Tamim101/Sky_Watch/docs/img/100n03a.jpg

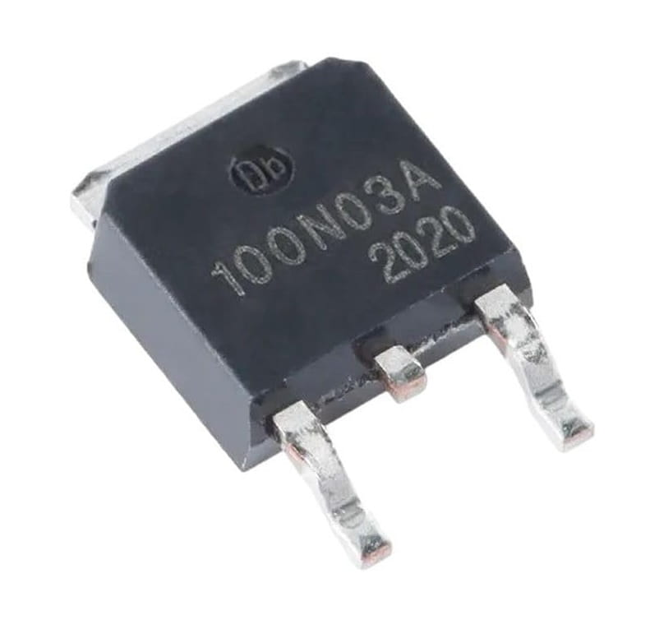
docs/img/100n03a.jpg
