Tamim101/Sky_Watch/docs/img/battery.jpg

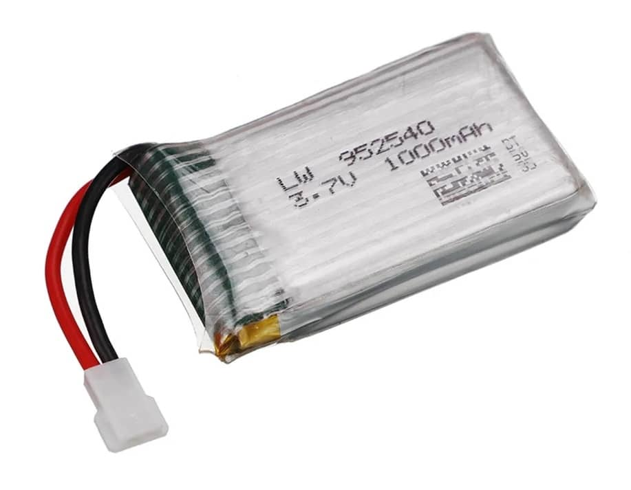
docs/img/battery.jpg
