Tamim101/Sky_Watch/docs/img/betafpv.jpg

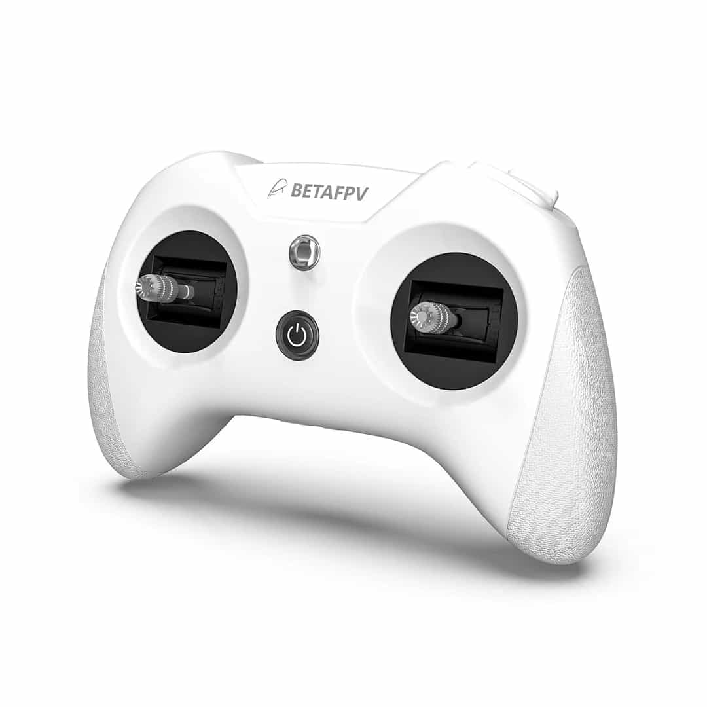
docs/img/betafpv.jpg
