Tamim101/Sky_Watch/docs/img/buck-boost.jpg

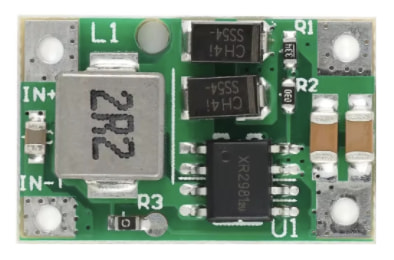
docs/img/buck-boost.jpg
