Tamim101/Sky_Watch/docs/img/charger.jpg

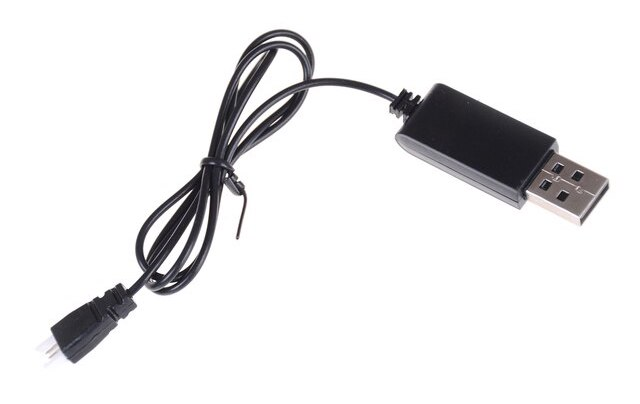
docs/img/charger.jpg
