Tamim101/Sky_Watch/docs/img/esc.jpg

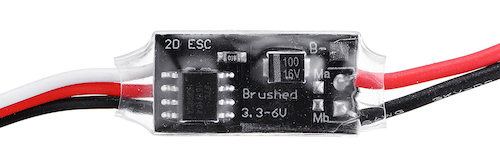
docs/img/esc.jpg
