Tamim101/Sky_Watch/docs/img/esp32-holder.jpg

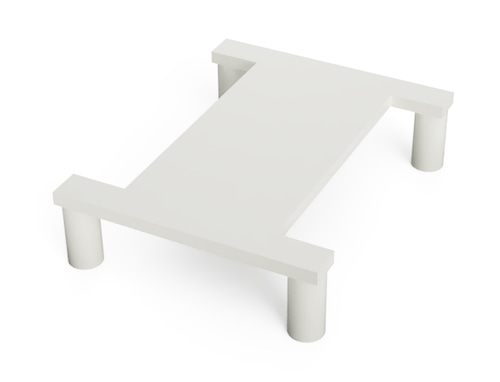
docs/img/esp32-holder.jpg
