Tamim101/Sky_Watch/docs/img/esp32.jpg

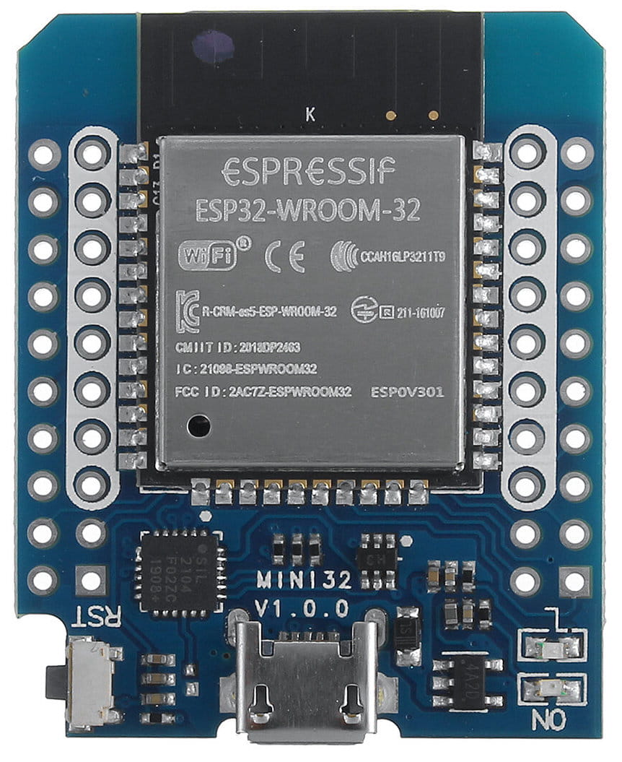
docs/img/esp32.jpg
