Tamim101/Sky_Watch/docs/img/flight-video.jpg

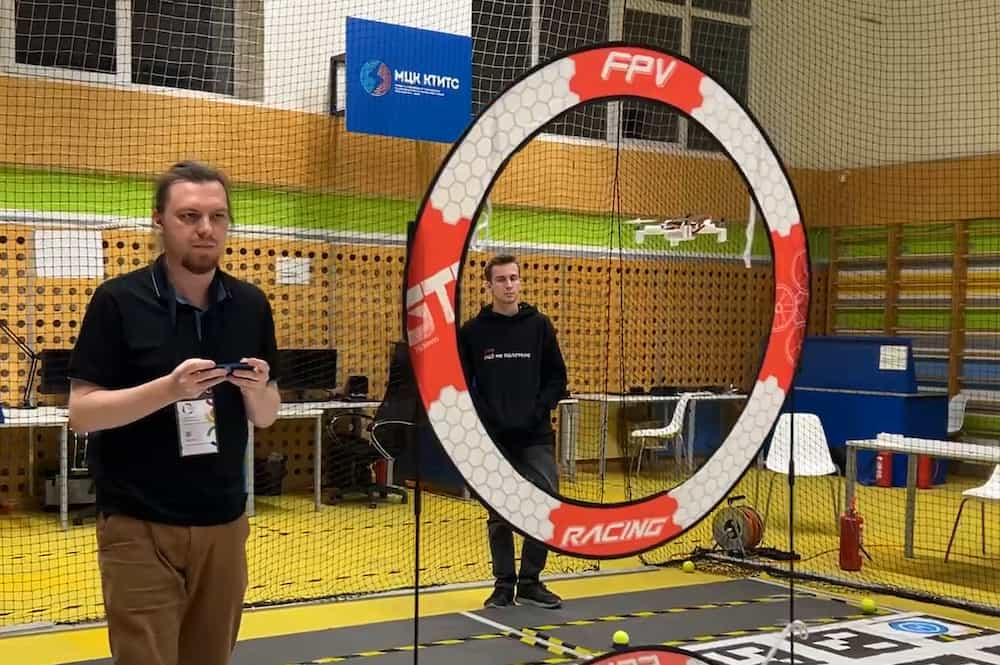
docs/img/flight-video.jpg
