Tamim101/Sky_Watch/docs/img/flightplot.png

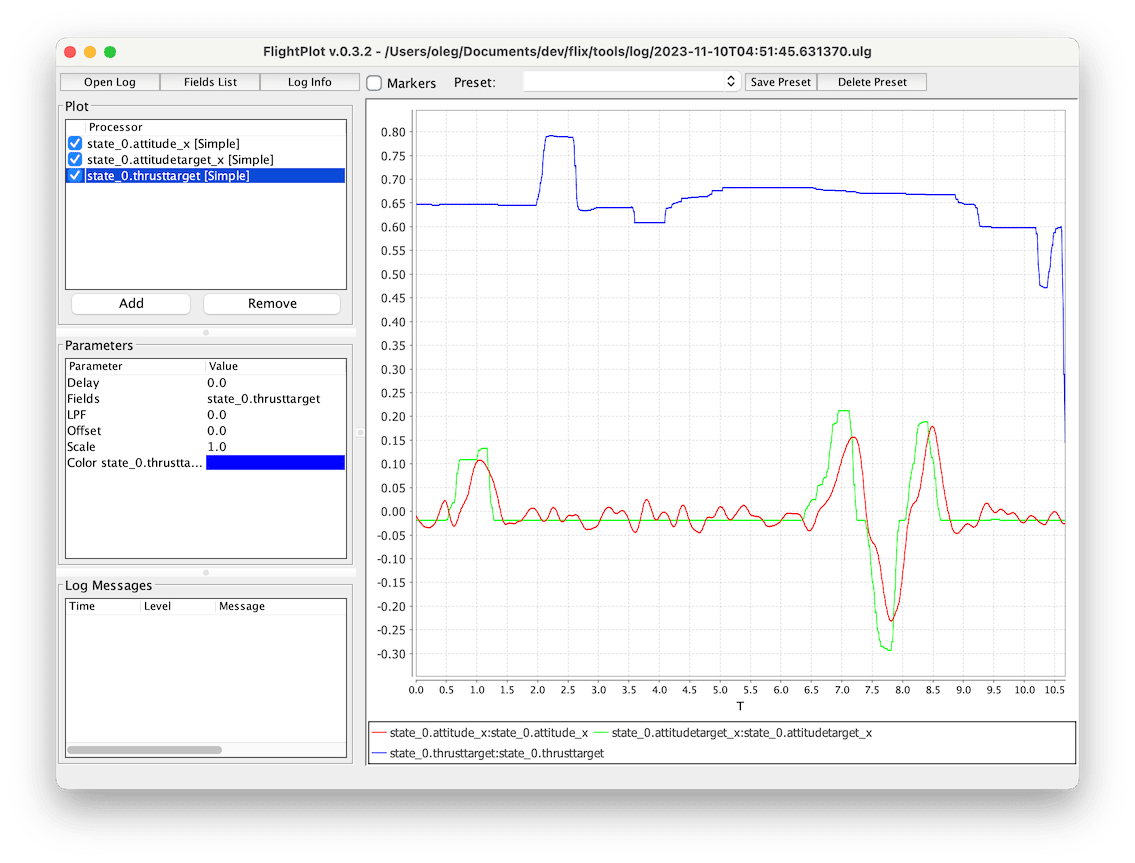
docs/img/flightplot.png
