Tamim101/Sky_Watch/docs/img/flix1.jpg

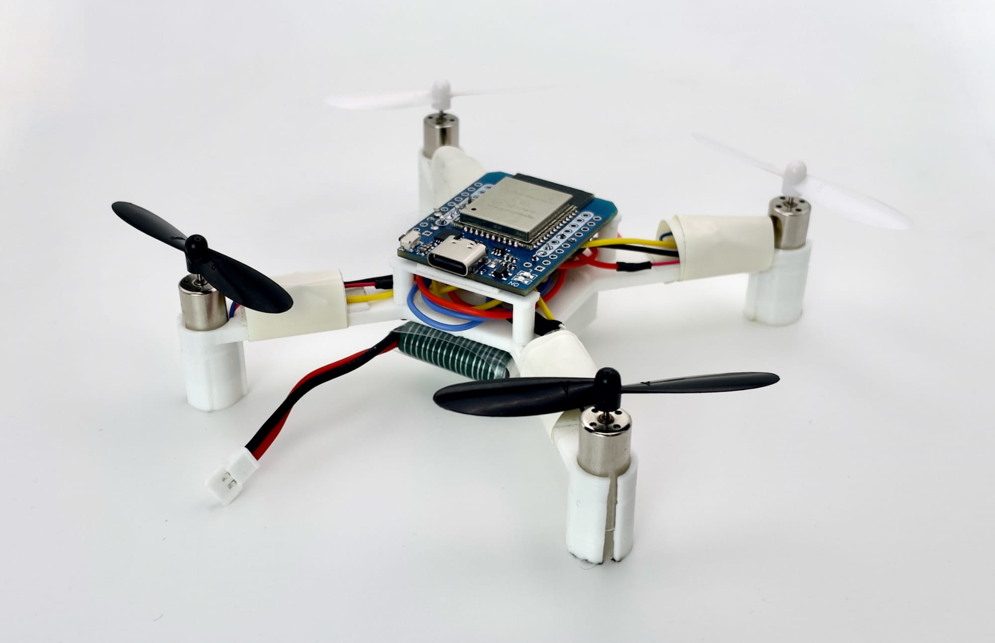
docs/img/flix1.jpg
