Tamim101/Sky_Watch/docs/img/flix.jpg

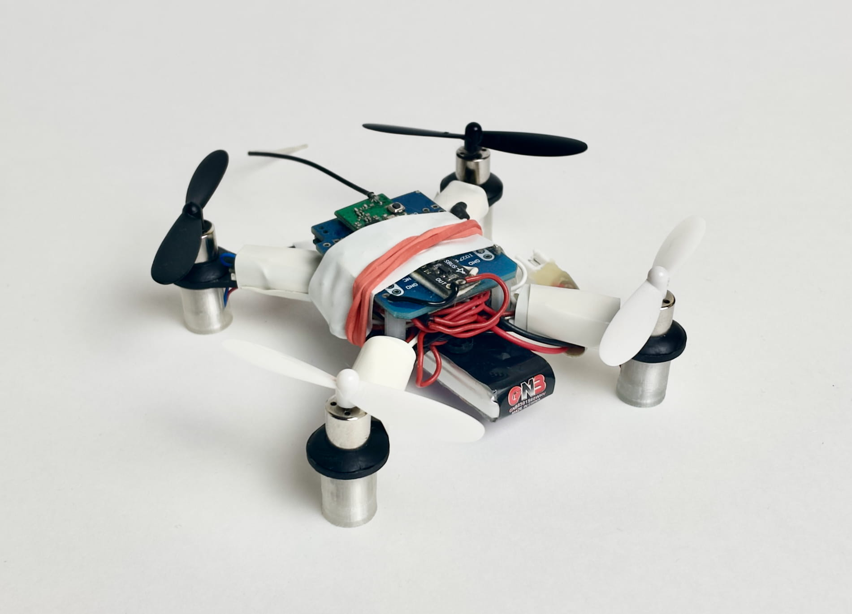
docs/img/flix.jpg
