Tamim101/Sky_Watch/docs/img/flixperiph.png

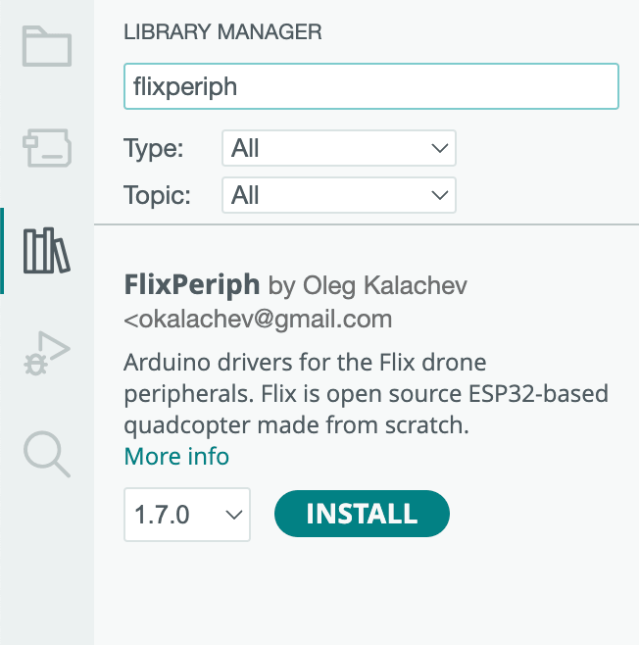
docs/img/flixperiph.png
