Tamim101/Sky_Watch/docs/img/foxglove.png

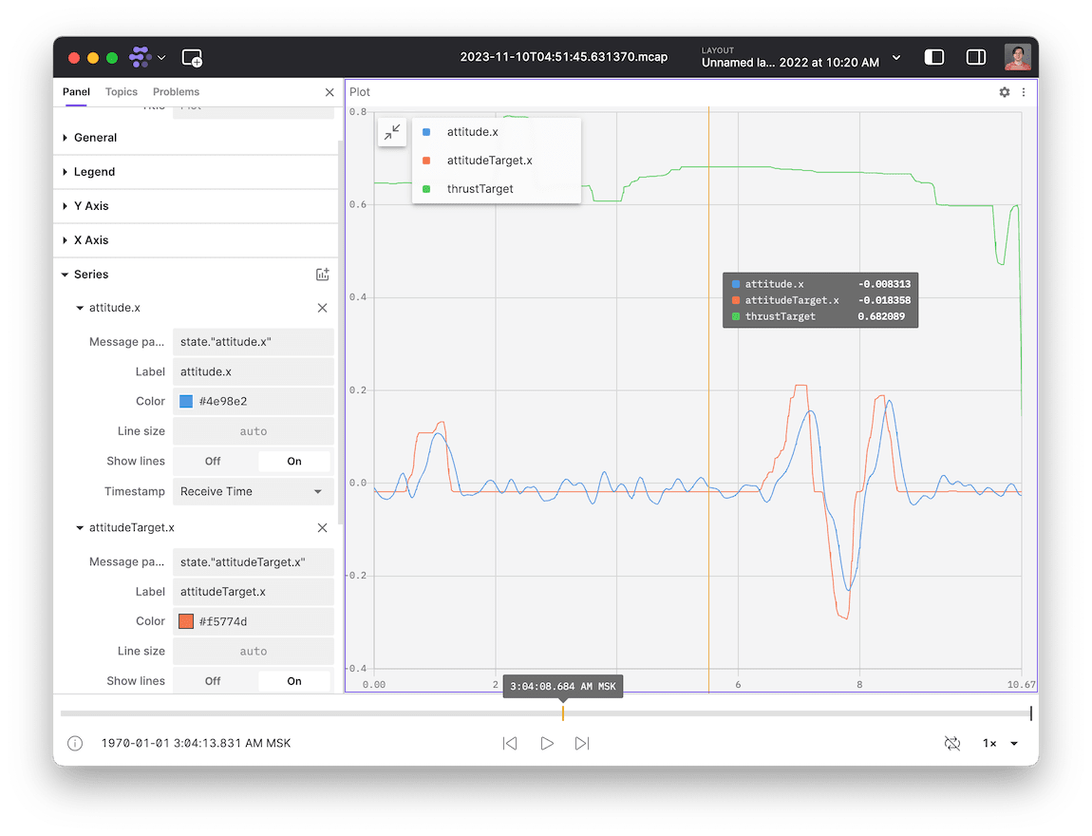
docs/img/foxglove.png
