Tamim101/Sky_Watch/docs/img/frame1.jpg

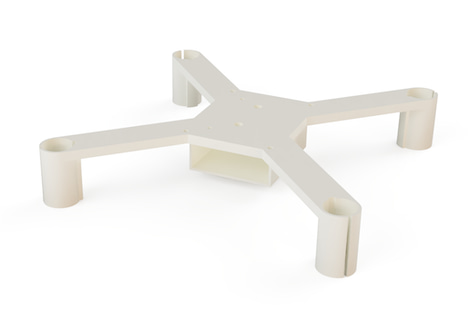
docs/img/frame1.jpg
