Tamim101/Sky_Watch/docs/img/frame.jpg

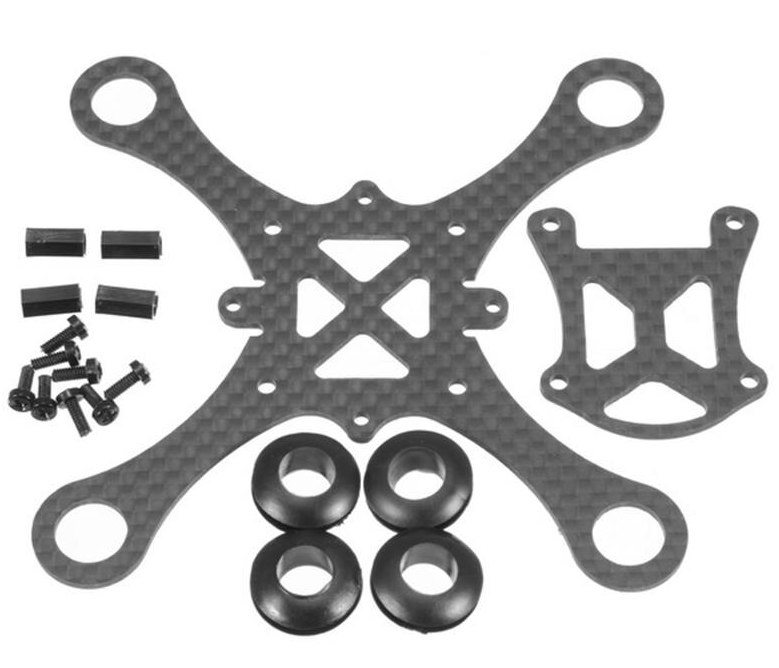
docs/img/frame.jpg
