Tamim101/Sky_Watch/docs/img/gy-91.jpg

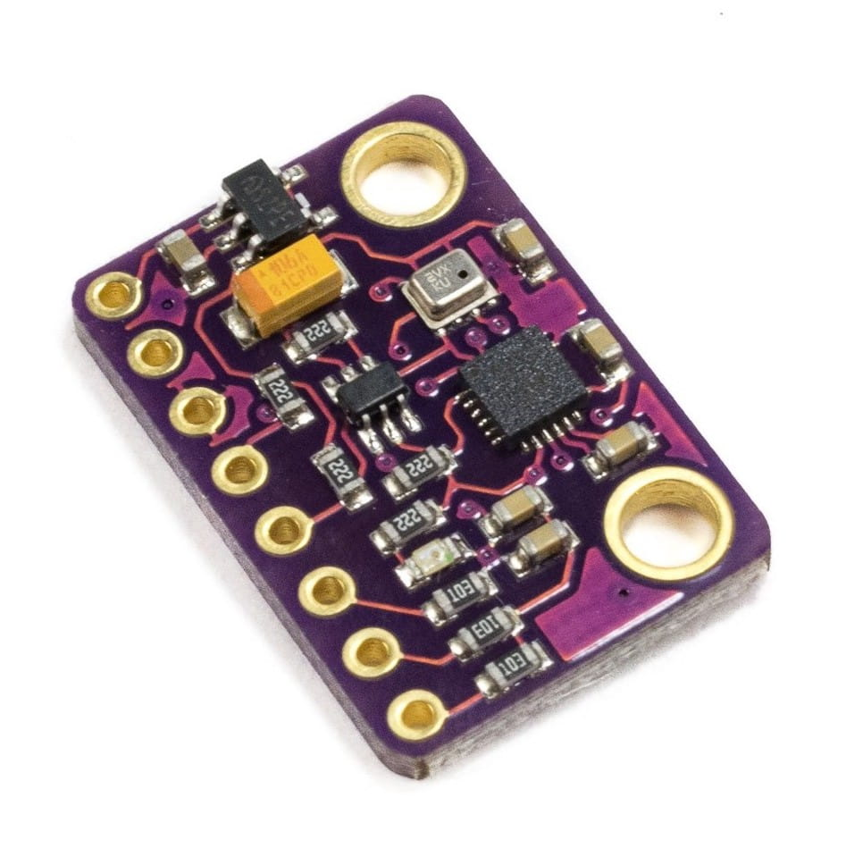
docs/img/gy-91.jpg
