Tamim101/Sky_Watch/docs/img/gy-521.jpg

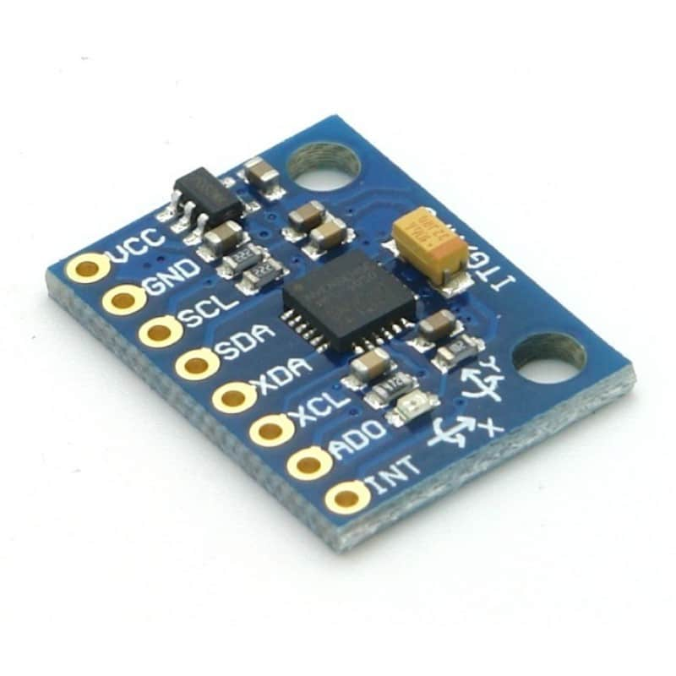
docs/img/gy-521.jpg
