Tamim101/Sky_Watch/docs/img/gyro-plotter.png

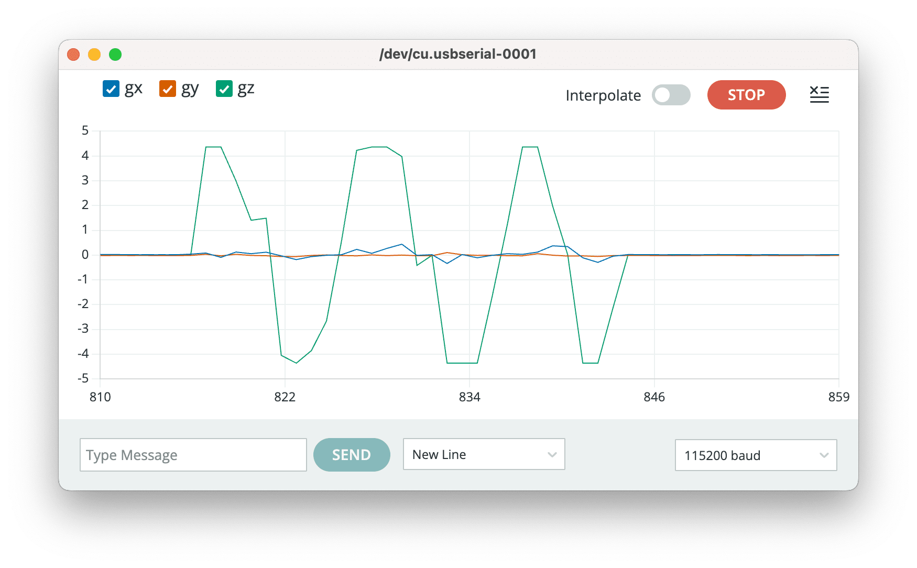
docs/img/gyro-plotter.png
