Tamim101/Sky_Watch/docs/img/gyroscope.jpg

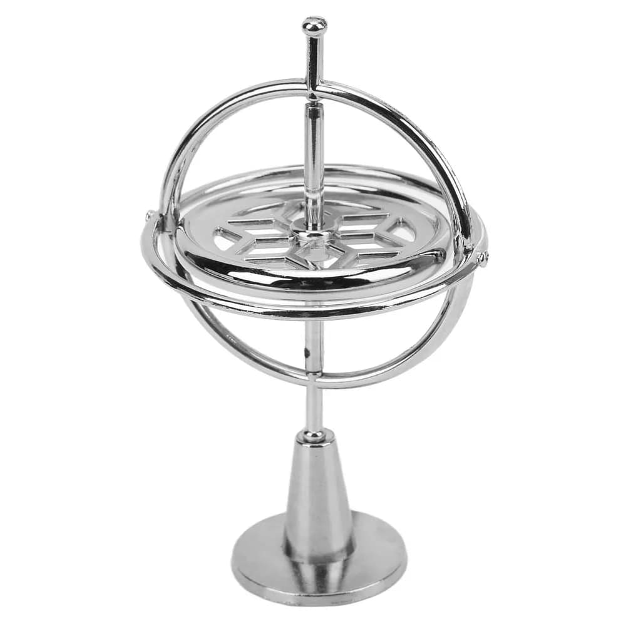
docs/img/gyroscope.jpg
