Tamim101/Sky_Watch/docs/img/icm-20948.jpg

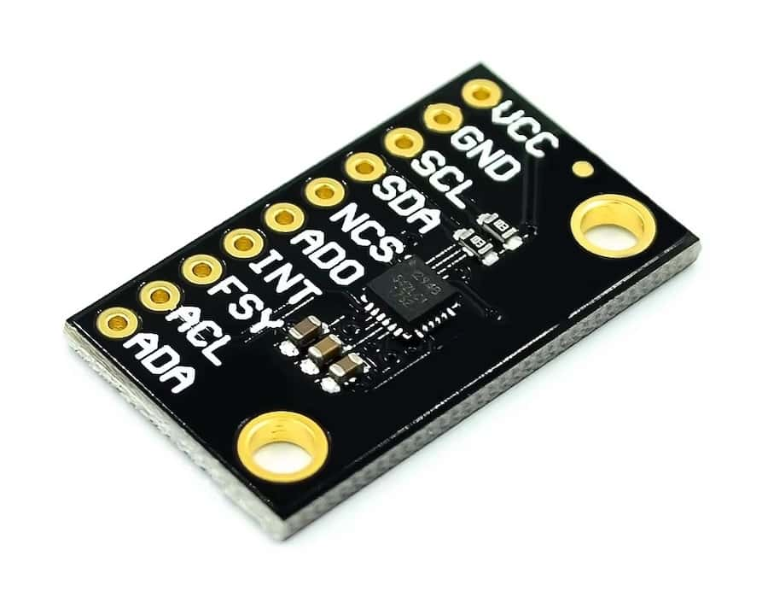
docs/img/icm-20948.jpg
