Tamim101/Sky_Watch/docs/img/inv.jpg

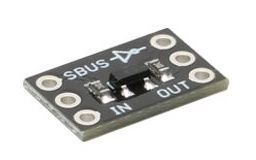
docs/img/inv.jpg
