Tamim101/Sky_Watch/docs/img/kingkong.jpg

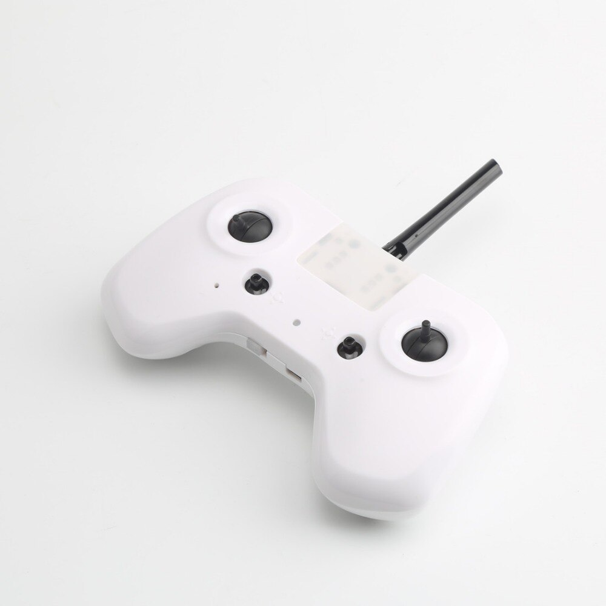
docs/img/kingkong.jpg
