Tamim101/Sky_Watch/docs/img/logitech.jpg

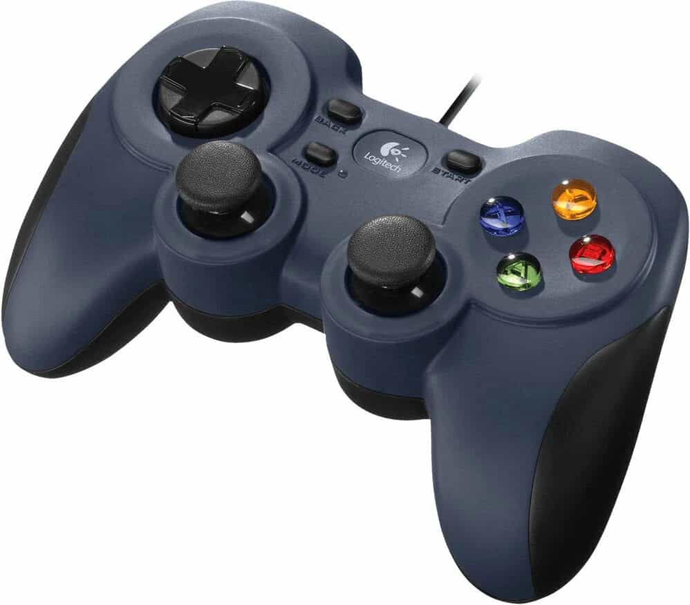
docs/img/logitech.jpg
