Tamim101/Sky_Watch/docs/img/mosfet-connection.png

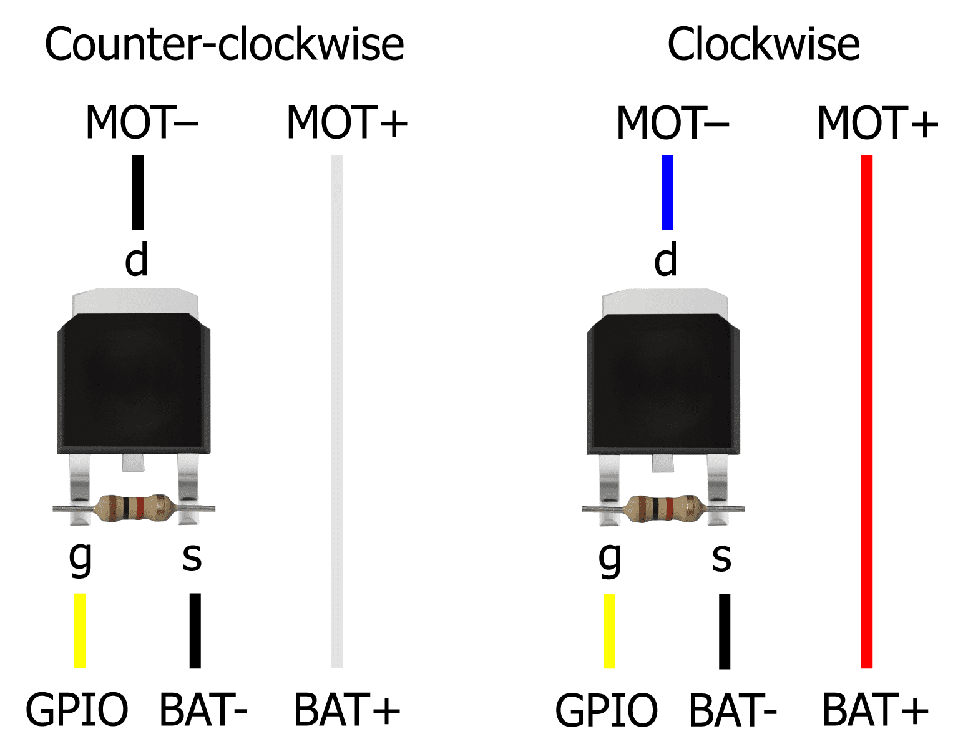
docs/img/mosfet-connection.png
