Tamim101/Sky_Watch/docs/img/motor.jpeg

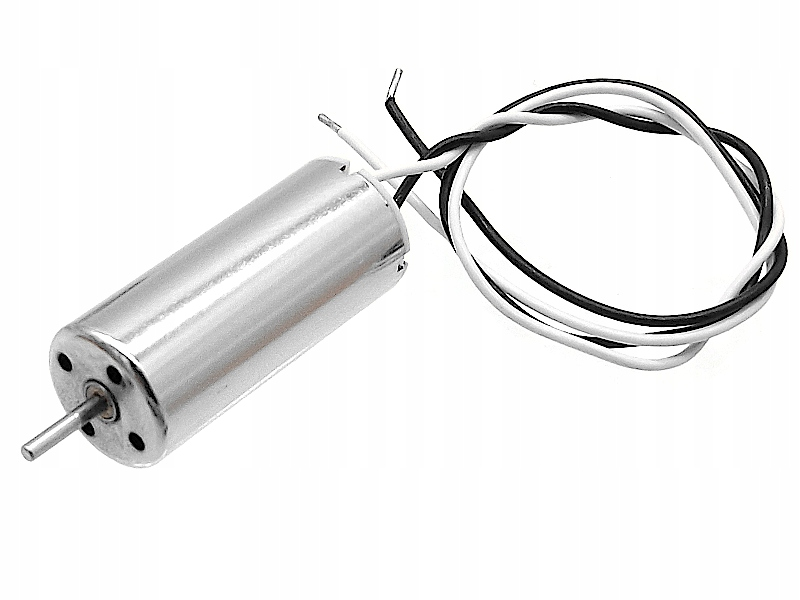
docs/img/motor.jpeg
