Tamim101/Sky_Watch/docs/img/mpu9250.jpg

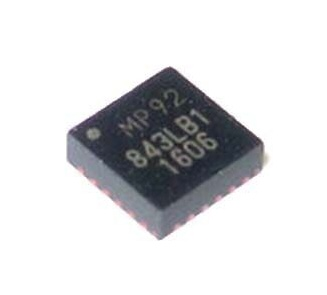
docs/img/mpu9250.jpg
