Tamim101/Sky_Watch/docs/img/mx.png

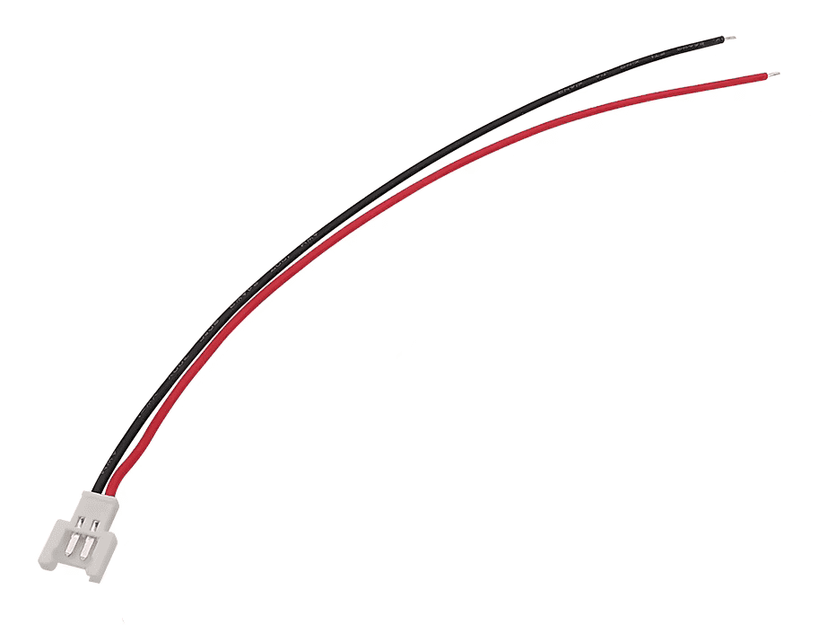
docs/img/mx.png
