Tamim101/Sky_Watch/docs/img/plotjuggler.png

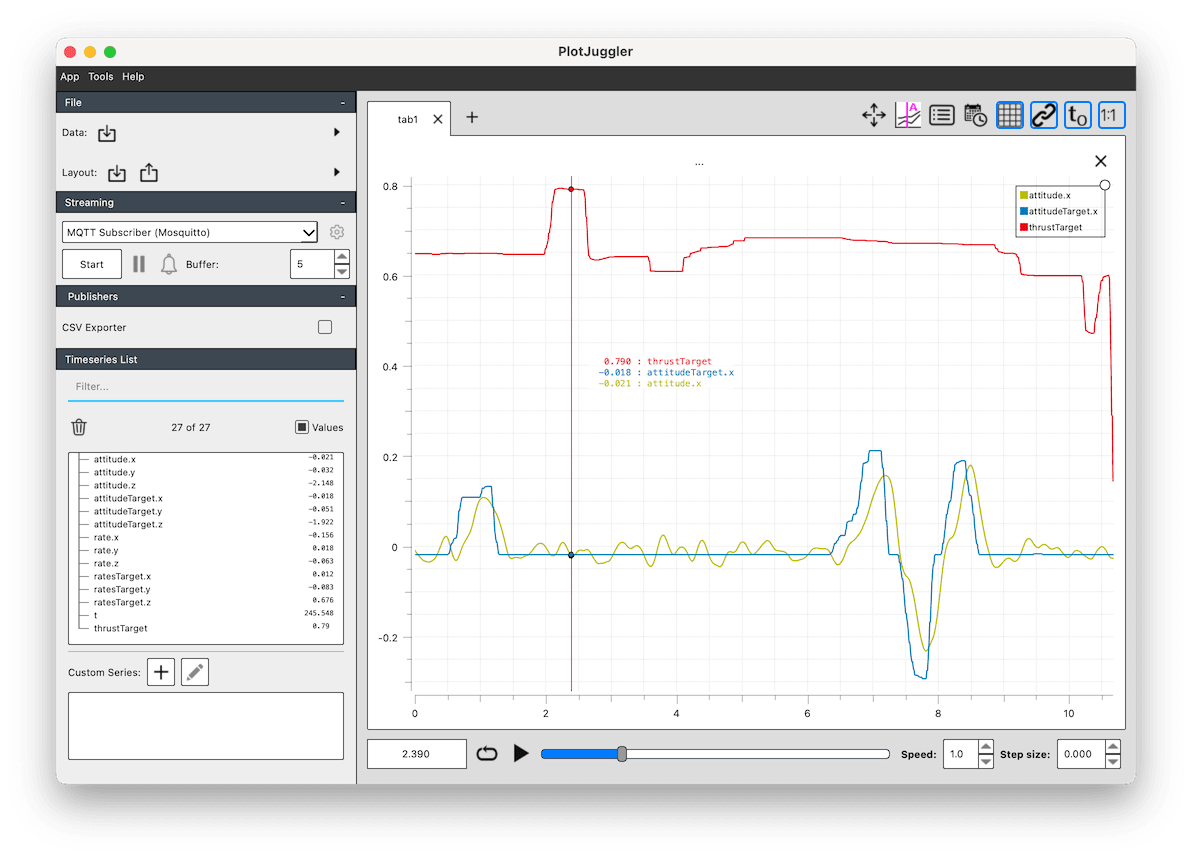
docs/img/plotjuggler.png
