Tamim101/Sky_Watch/docs/img/prop.jpg

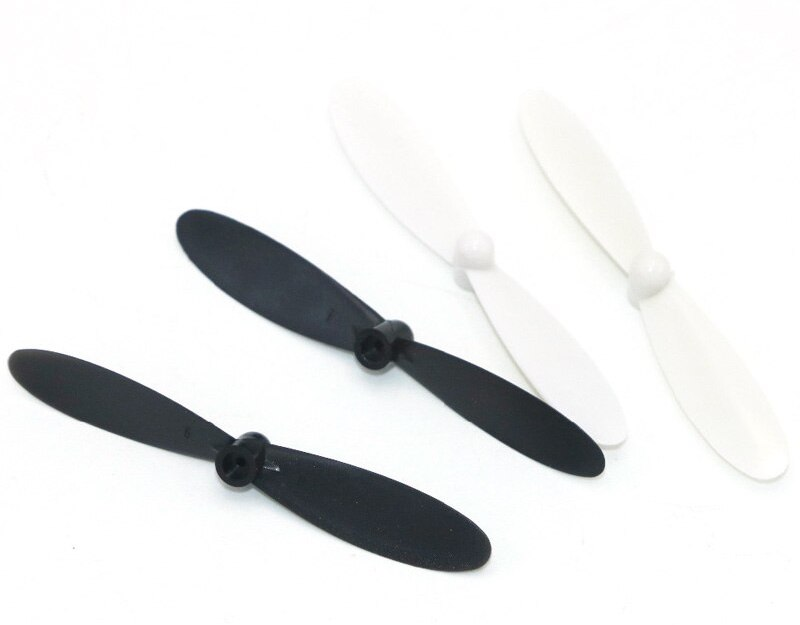
docs/img/prop.jpg
