Tamim101/Sky_Watch/docs/img/qgc-attitude.png

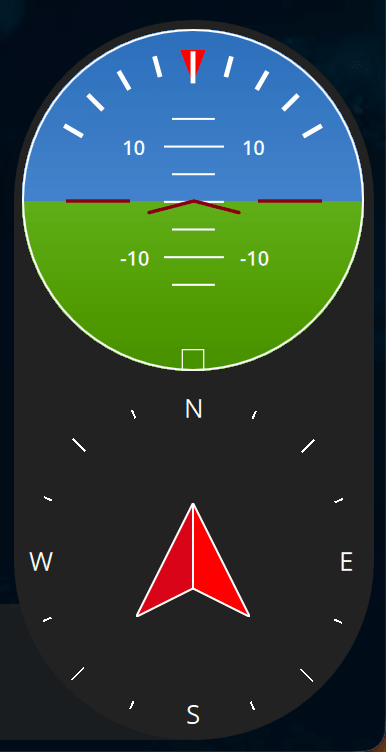
docs/img/qgc-attitude.png
