Tamim101/Sky_Watch/docs/img/qgc-proxy.png

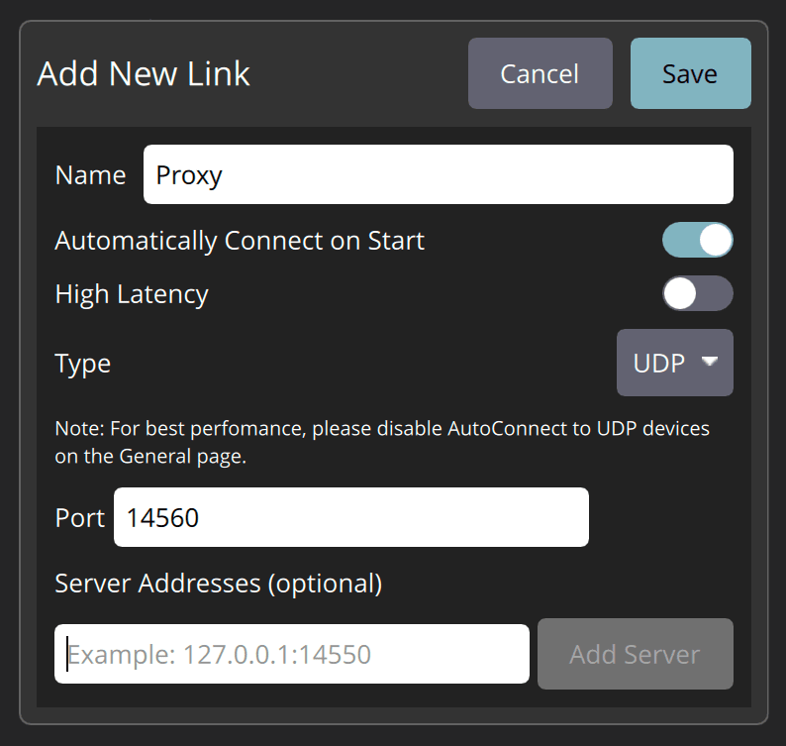
docs/img/qgc-proxy.png
