Tamim101/Sky_Watch/docs/img/resistor10k.jpg

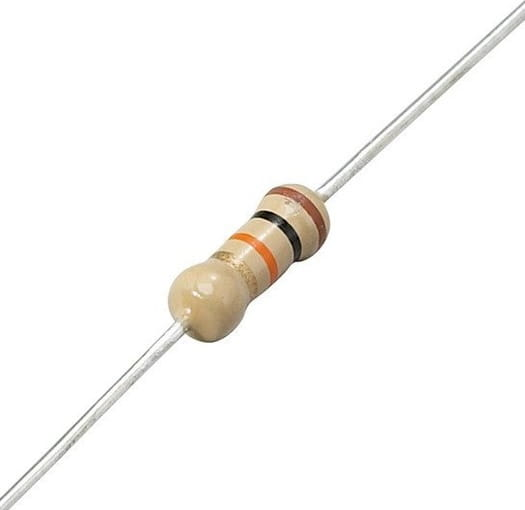
docs/img/resistor10k.jpg
