Tamim101/Sky_Watch/docs/img/rx.jpg

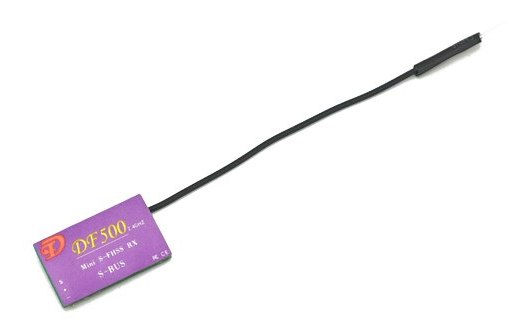
docs/img/rx.jpg
