Tamim101/Sky_Watch/docs/img/screw-m1.4.jpg

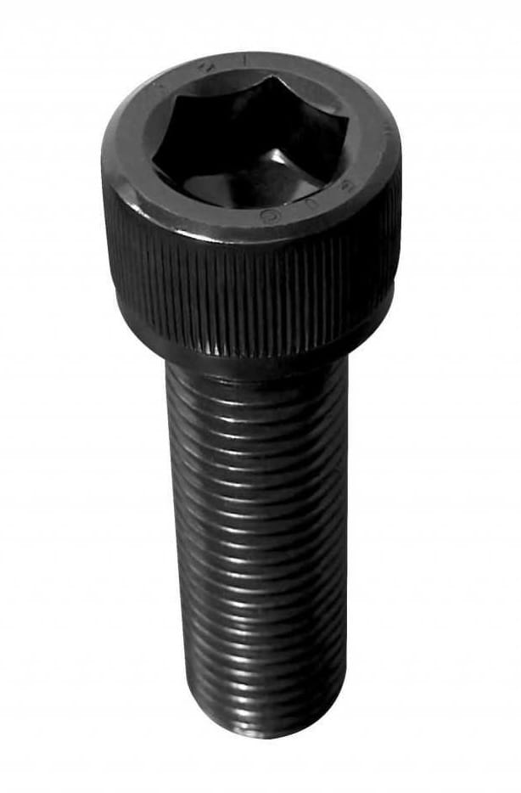
docs/img/screw-m1.4.jpg
