Tamim101/Sky_Watch/docs/img/screw-m3.jpg

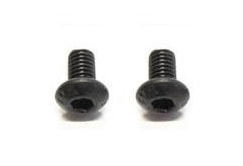
docs/img/screw-m3.jpg
