Tamim101/Sky_Watch/docs/img/simulator1.png

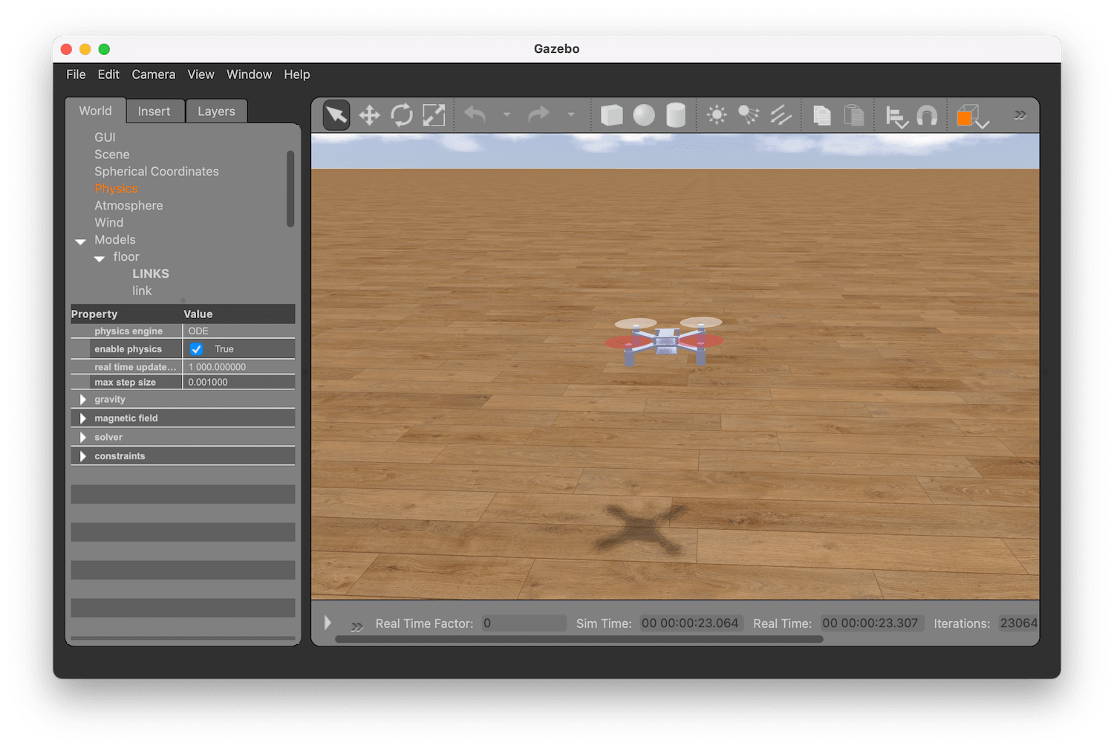
docs/img/simulator1.png
