Tamim101/Sky_Watch/docs/img/simulator.png

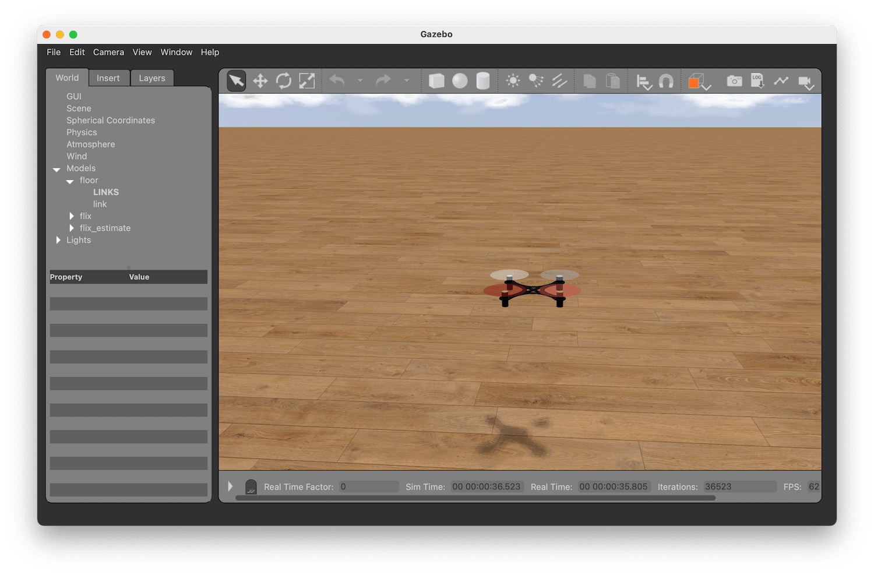
docs/img/simulator.png
