Tamim101/Sky_Watch/docs/img/user/alexey_karakash/1.jpg

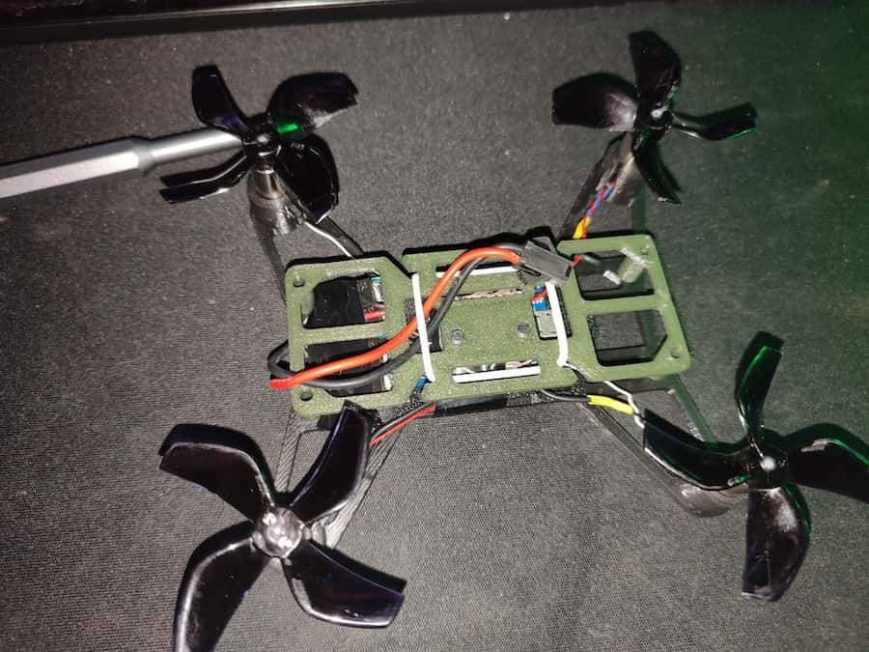
docs/img/user/alexey_karakash/1.jpg
