Tamim101/Sky_Watch/docs/img/user/alexey_karakash/2.jpg

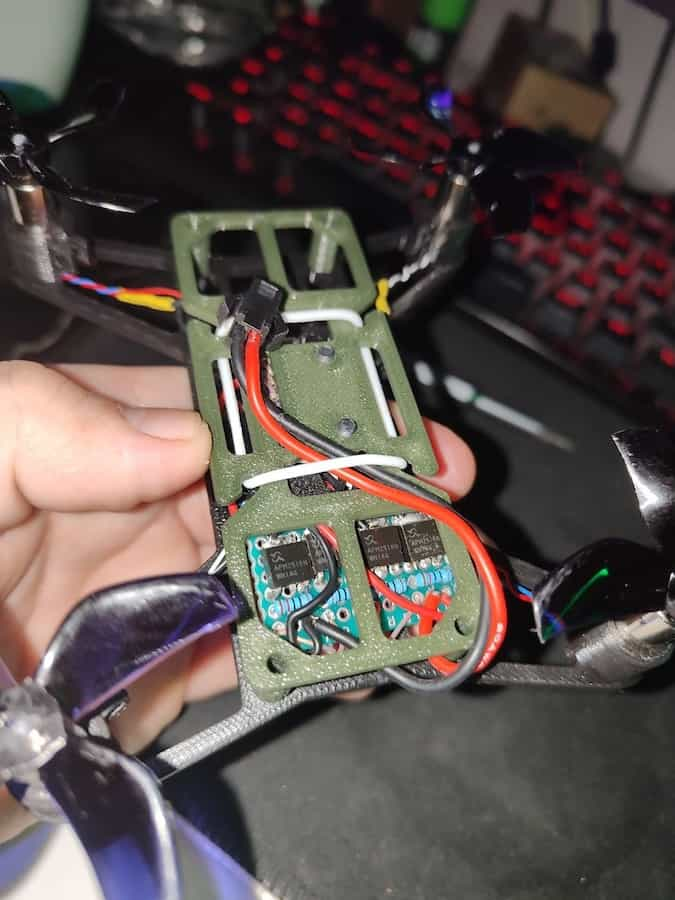
docs/img/user/alexey_karakash/2.jpg
