Tamim101/Sky_Watch/docs/img/user/alexey_karakash/3.jpg

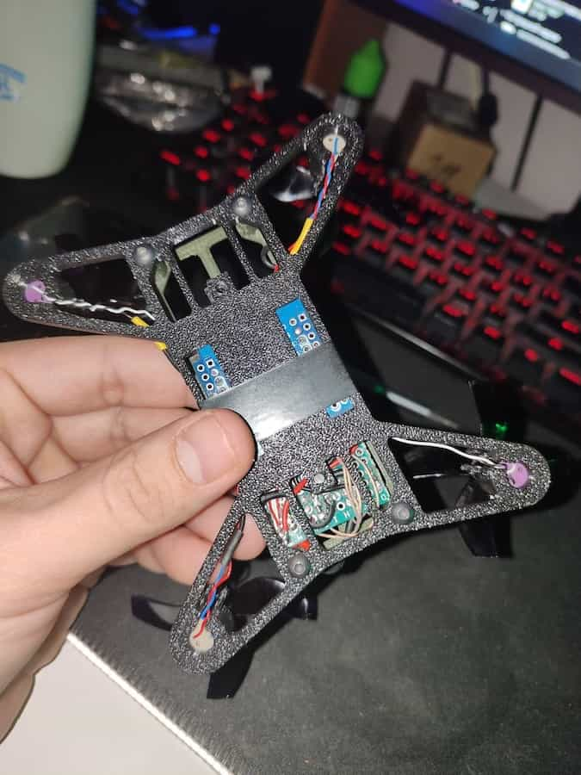
docs/img/user/alexey_karakash/3.jpg
