Tamim101/Sky_Watch/docs/img/user/alexey_karakash/4.jpg

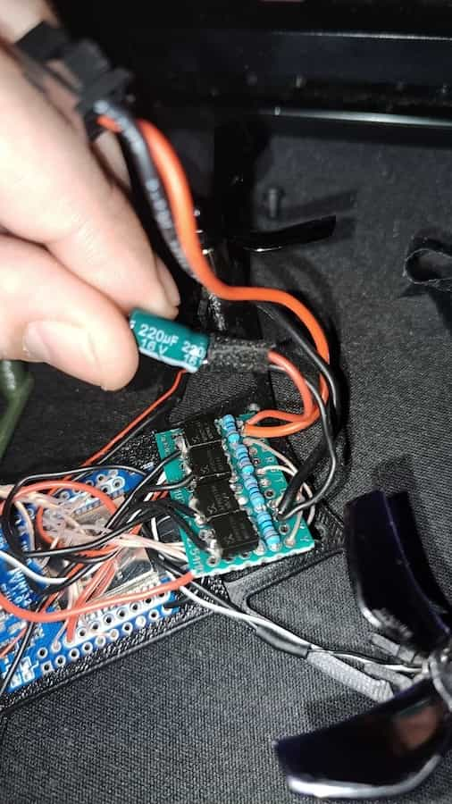
docs/img/user/alexey_karakash/4.jpg
