Tamim101/Sky_Watch/docs/img/user/alexey_karakash/video.jpg

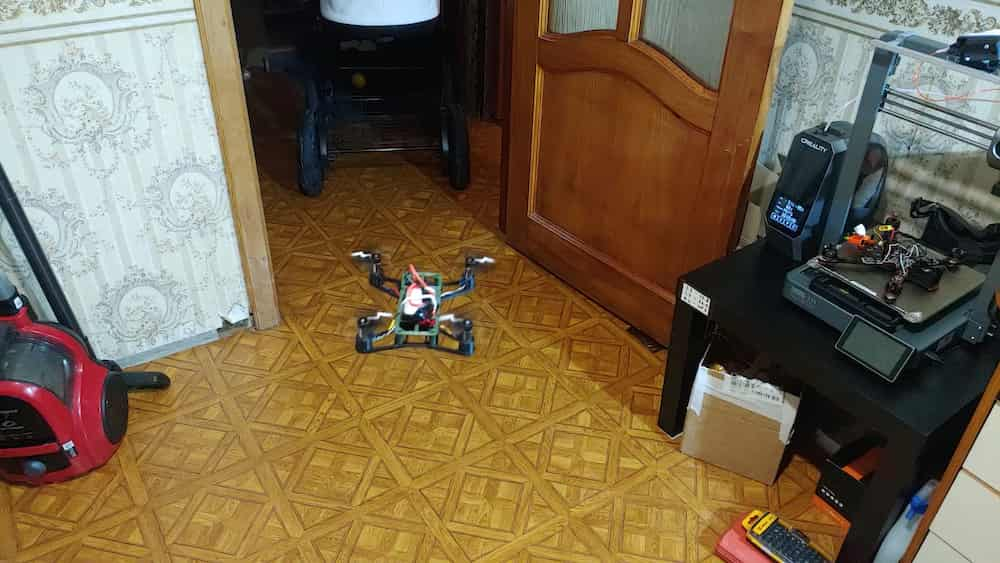
docs/img/user/alexey_karakash/video.jpg
