Tamim101/Sky_Watch/docs/img/user/chkroko-bldc/1.jpg

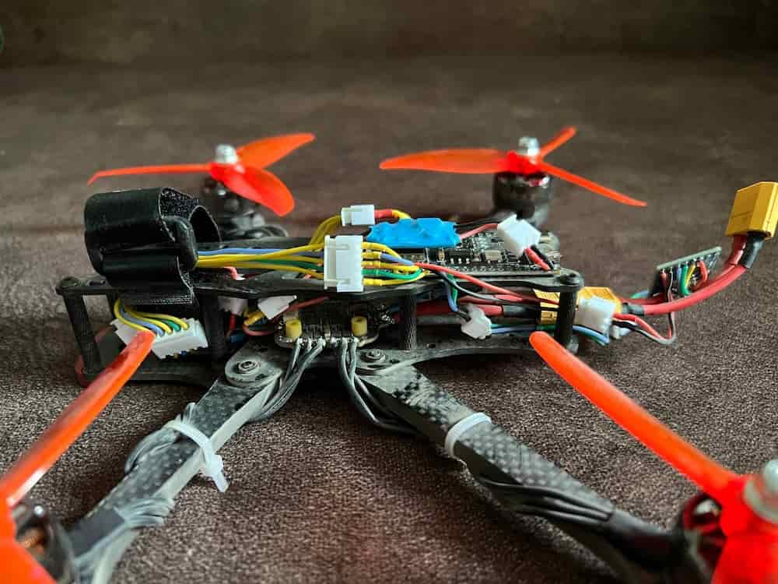
docs/img/user/chkroko-bldc/1.jpg
