Tamim101/Sky_Watch/docs/img/user/chkroko-bldc/2.jpg

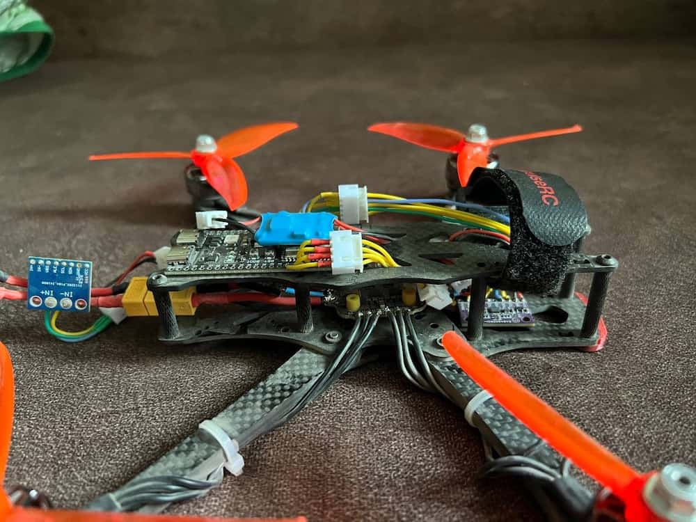
docs/img/user/chkroko-bldc/2.jpg
