Tamim101/Sky_Watch/docs/img/user/chkroko-bldc/3.jpg

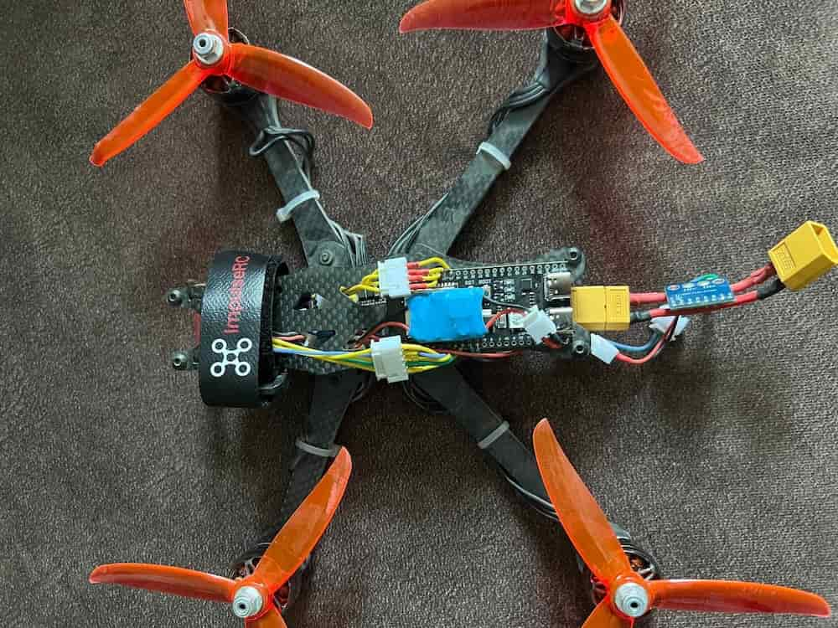
docs/img/user/chkroko-bldc/3.jpg
