Tamim101/Sky_Watch/docs/img/user/chkroko-bldc/video.jpg

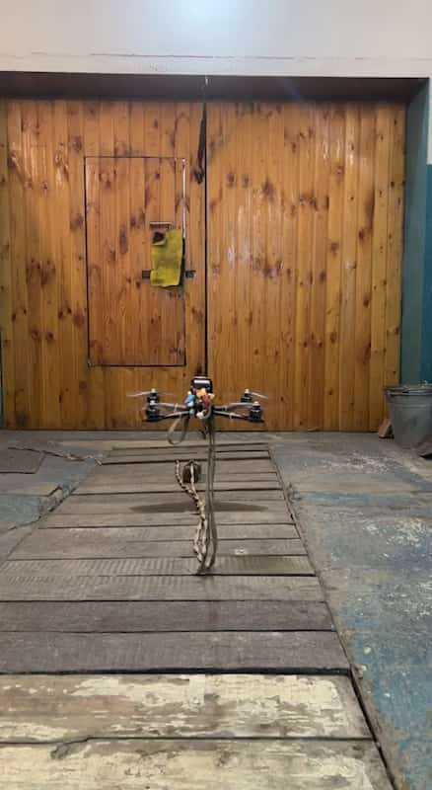
docs/img/user/chkroko-bldc/video.jpg
