Tamim101/Sky_Watch/docs/img/user/chkroko/1.jpg

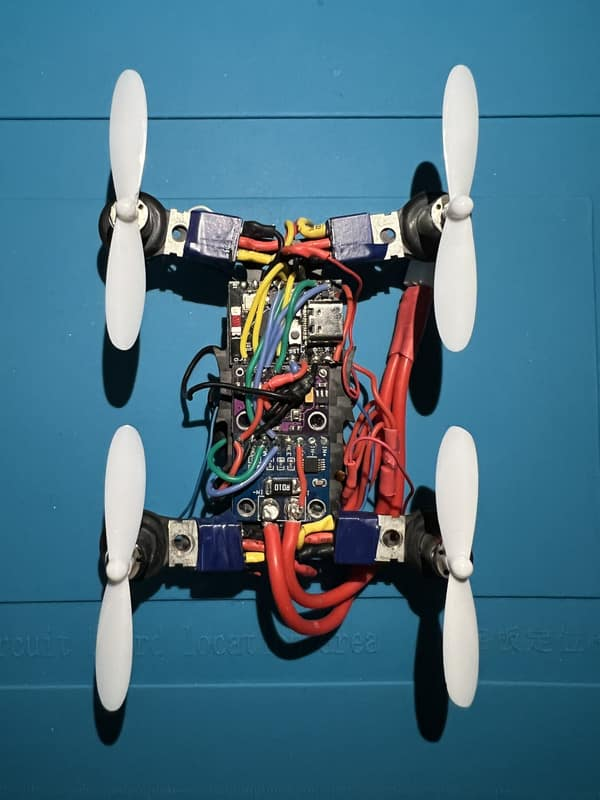
docs/img/user/chkroko/1.jpg
