Tamim101/Sky_Watch/docs/img/user/chkroko/2.jpg

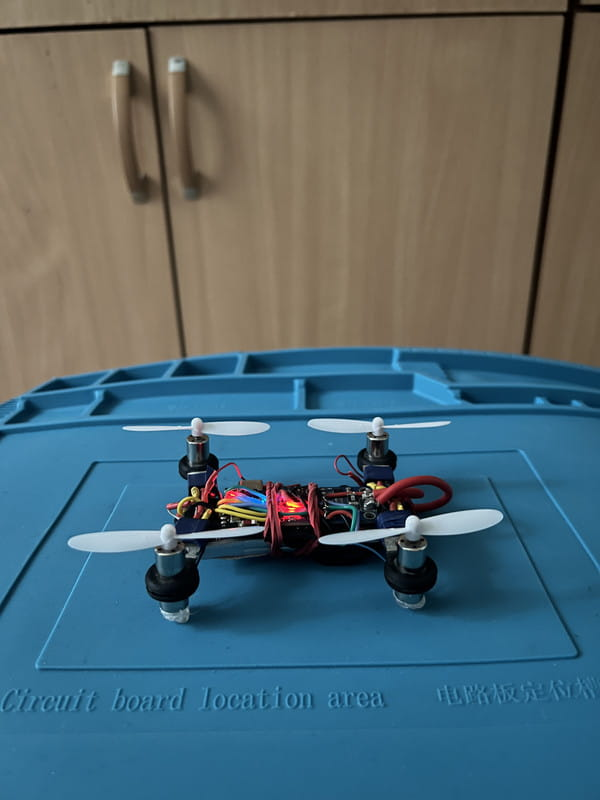
docs/img/user/chkroko/2.jpg
