Tamim101/Sky_Watch/docs/img/user/chkroko/video.jpg

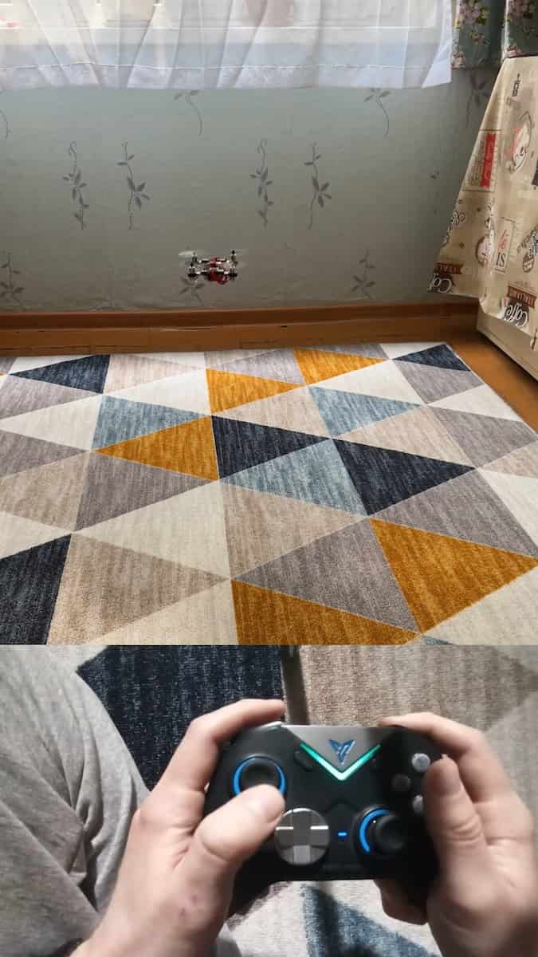
docs/img/user/chkroko/video.jpg
