Tamim101/Sky_Watch/docs/img/user/cryptokobans/1.jpg

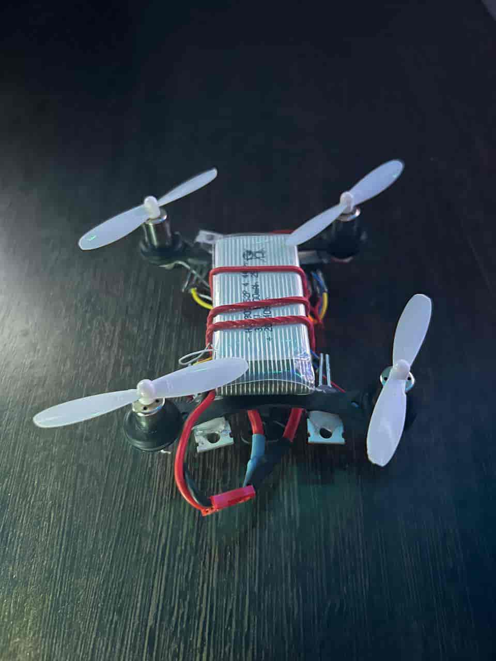
docs/img/user/cryptokobans/1.jpg
