Tamim101/Sky_Watch/docs/img/user/cryptokobans/2.jpg

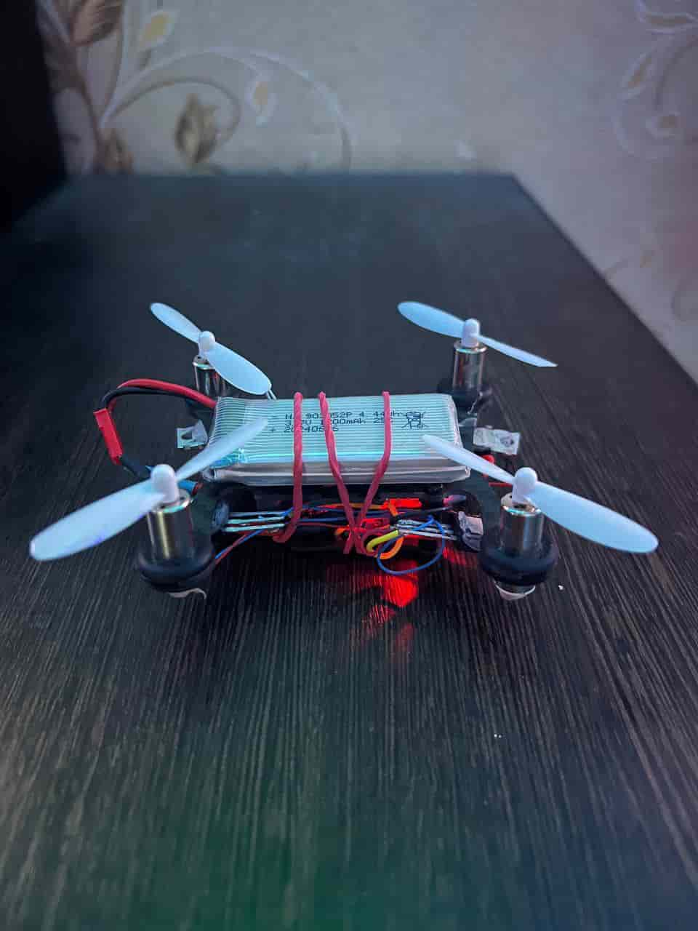
docs/img/user/cryptokobans/2.jpg
