Tamim101/Sky_Watch/docs/img/user/cryptokobans/video.jpg

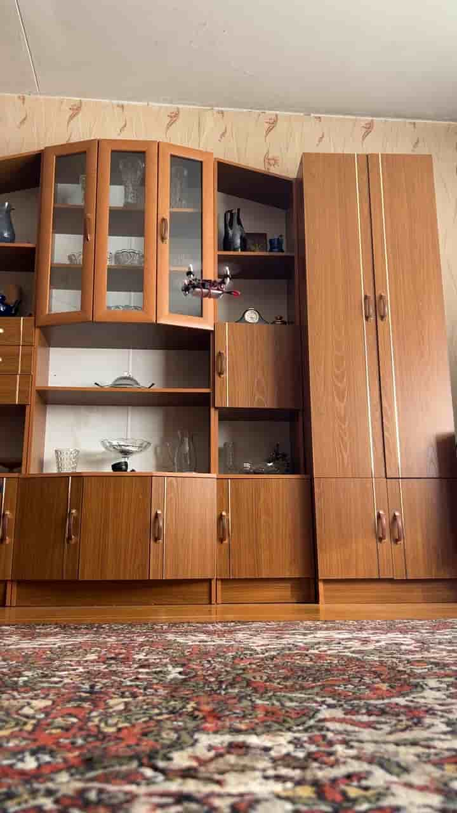
docs/img/user/cryptokobans/video.jpg
