Tamim101/Sky_Watch/docs/img/user/fisheyeu/1.jpg

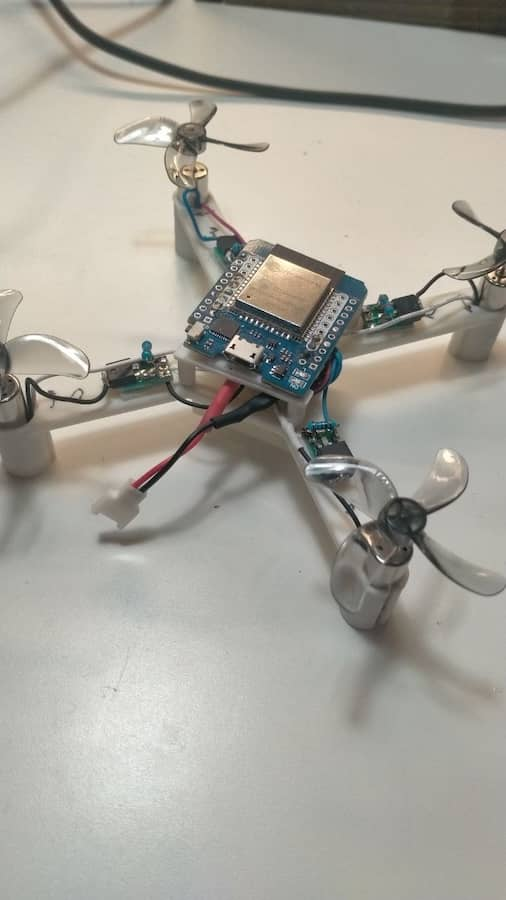
docs/img/user/fisheyeu/1.jpg
