Tamim101/Sky_Watch/docs/img/user/fisheyeu/2.jpg

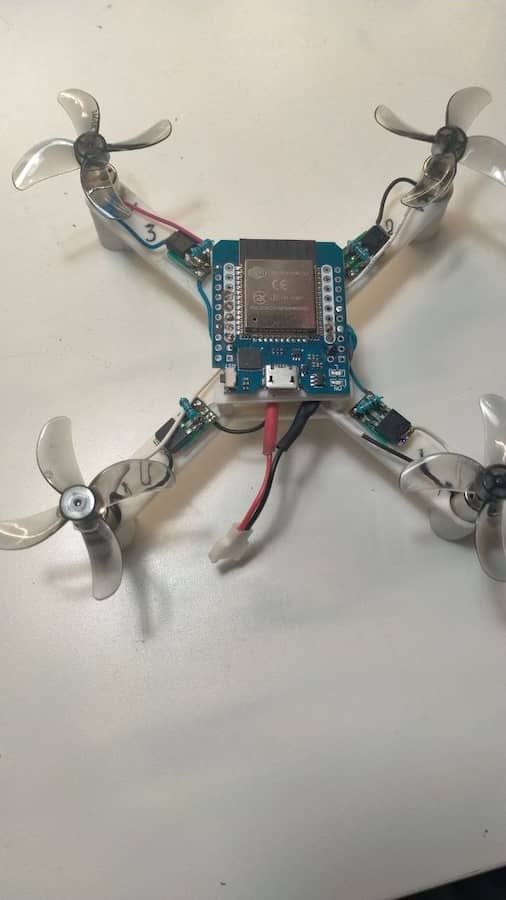
docs/img/user/fisheyeu/2.jpg
