Tamim101/Sky_Watch/docs/img/user/goldarte/1.jpg

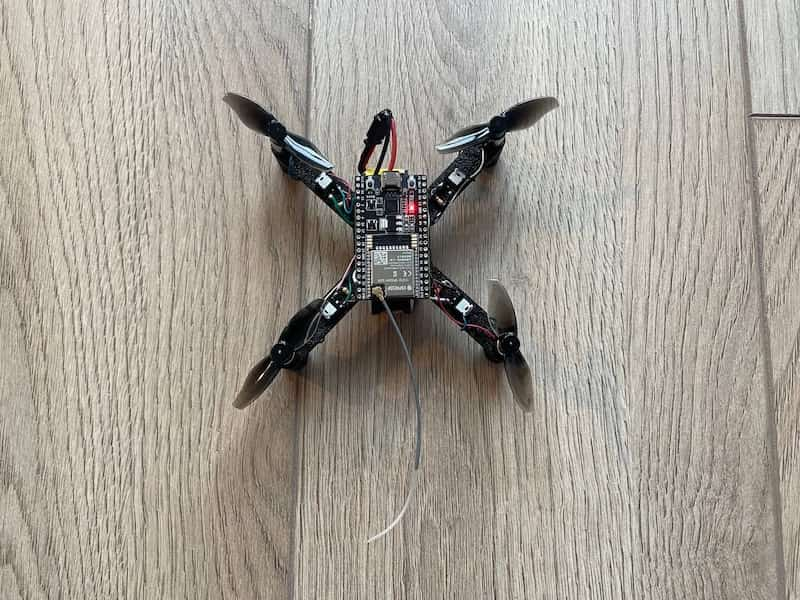
docs/img/user/goldarte/1.jpg
