Tamim101/Sky_Watch/docs/img/user/goldarte/2.jpg

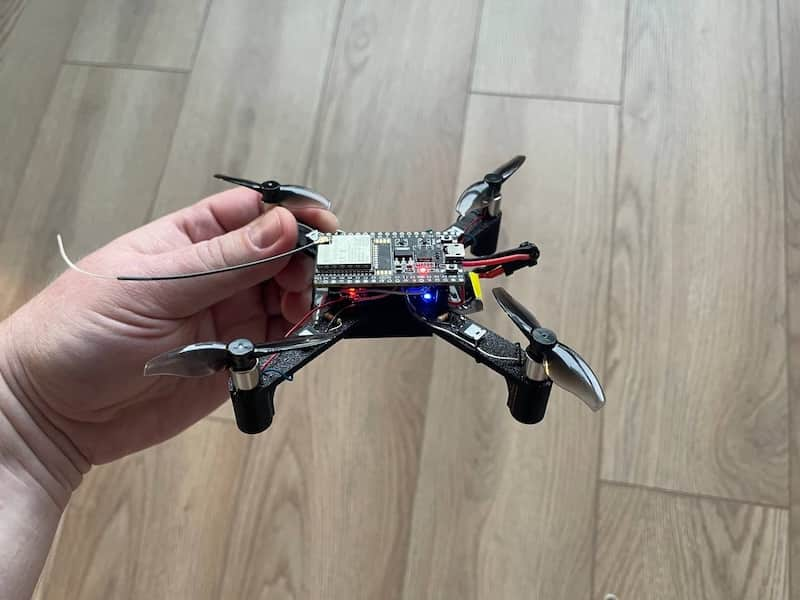
docs/img/user/goldarte/2.jpg
