Tamim101/Sky_Watch/docs/img/user/goldarte/video.jpg

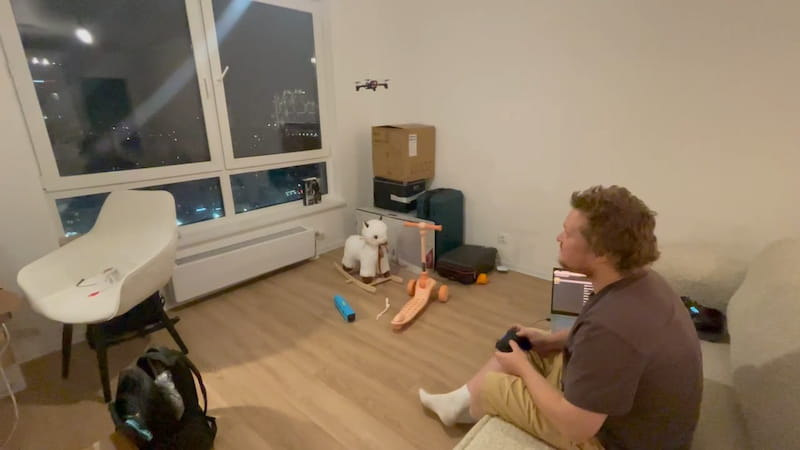
docs/img/user/goldarte/video.jpg
