Tamim101/Sky_Watch/docs/img/user/jeka_chex/2.jpg

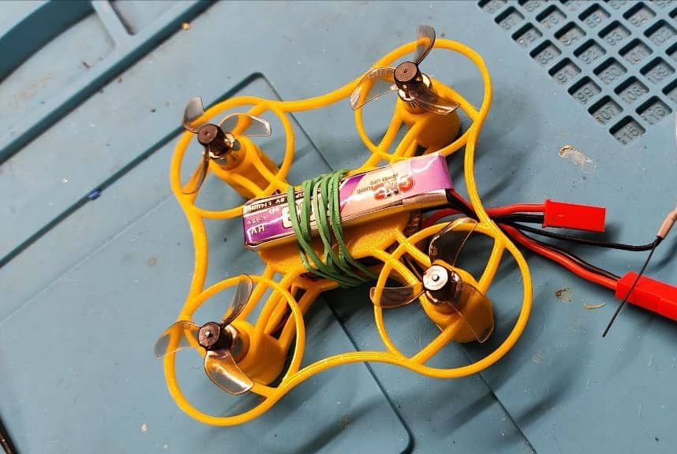
docs/img/user/jeka_chex/2.jpg
