Tamim101/Sky_Watch/docs/img/user/jeka_chex/3.jpg

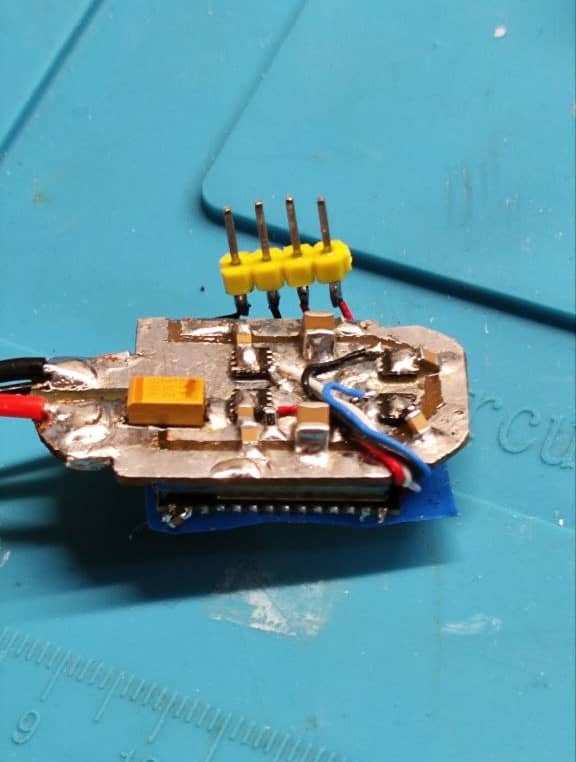
docs/img/user/jeka_chex/3.jpg
