Tamim101/Sky_Watch/docs/img/user/jeka_chex/4.jpg

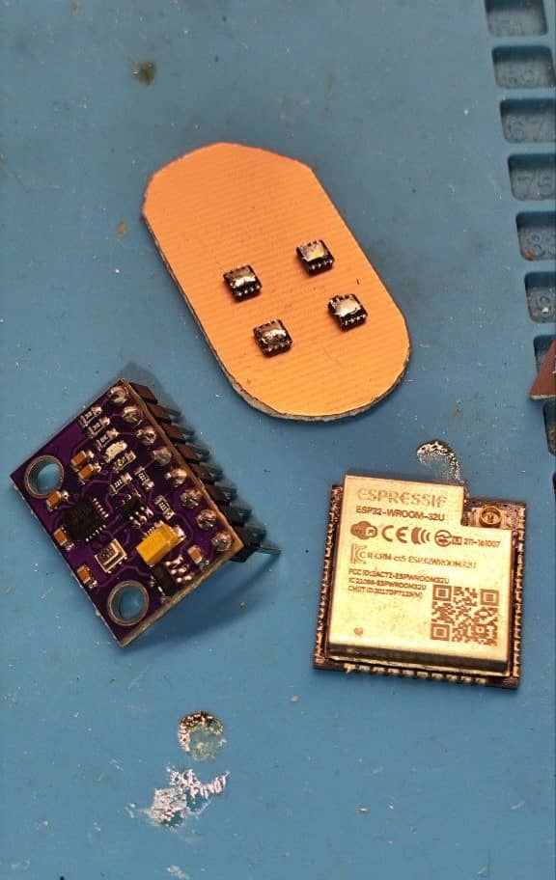
docs/img/user/jeka_chex/4.jpg
