Tamim101/Sky_Watch/docs/img/user/jeka_chex/5.jpg

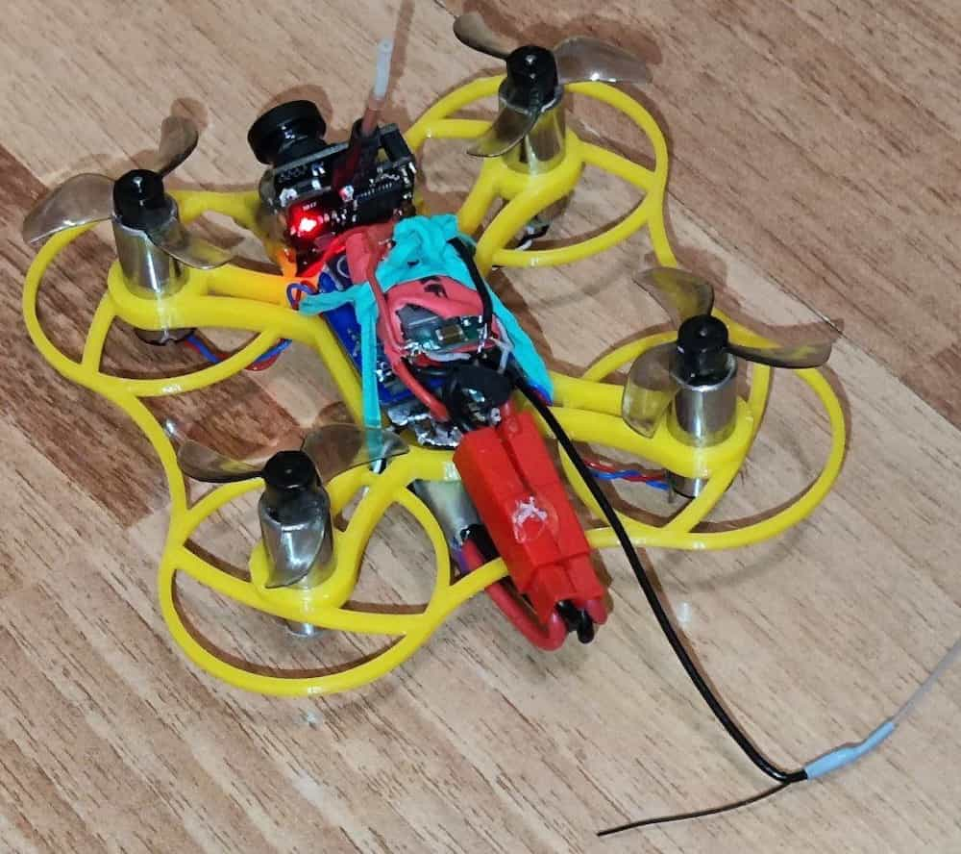
docs/img/user/jeka_chex/5.jpg
