Tamim101/Sky_Watch/docs/img/user/jeka_chex/video-fpv.jpg

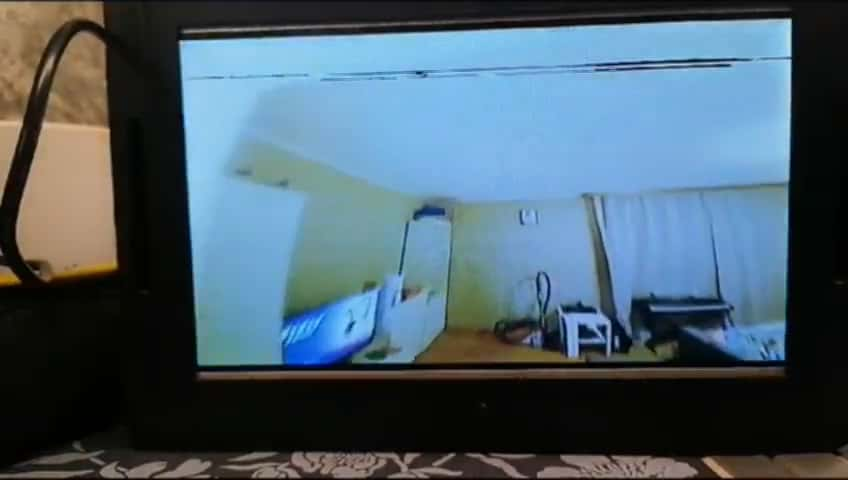
docs/img/user/jeka_chex/video-fpv.jpg
