Tamim101/Sky_Watch/docs/img/user/p_kabakov/1.jpg

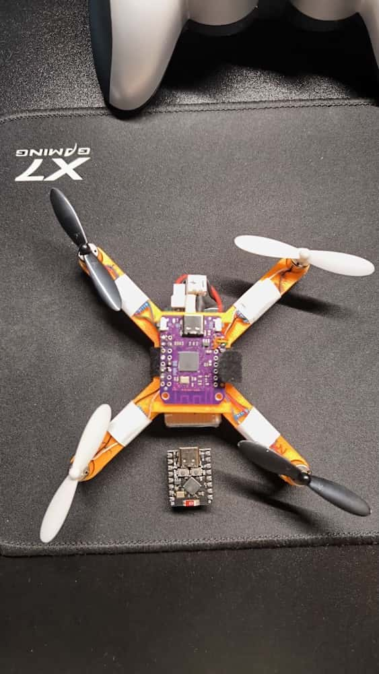
docs/img/user/p_kabakov/1.jpg
