Tamim101/Sky_Watch/docs/img/user/p_kabakov/2.jpg

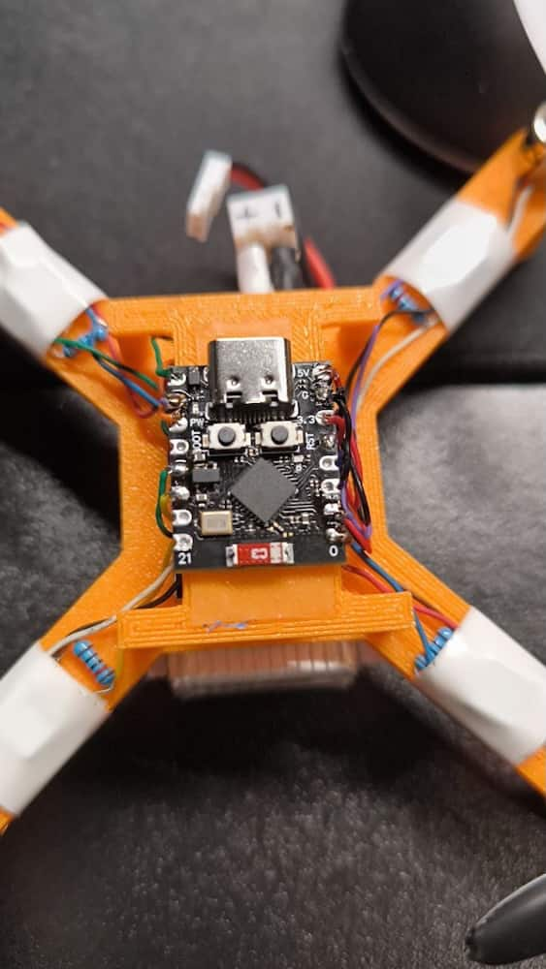
docs/img/user/p_kabakov/2.jpg
