Tamim101/Sky_Watch/docs/img/user/p_kabakov/3.jpg

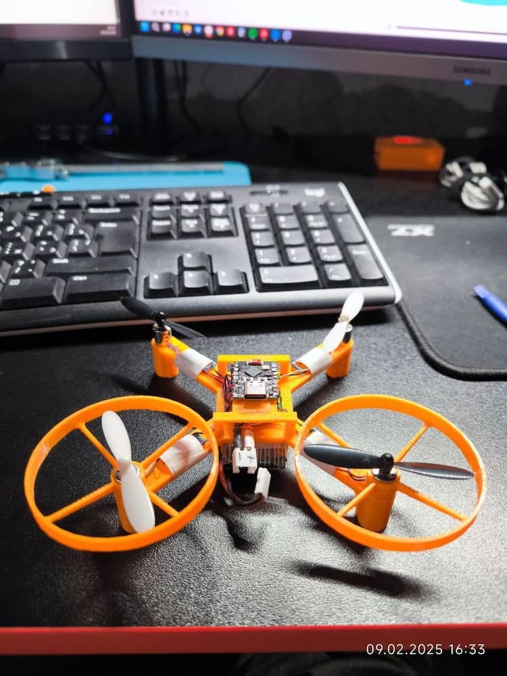
docs/img/user/p_kabakov/3.jpg
