Tamim101/Sky_Watch/docs/img/user/p_kabakov/wifirc.jpg

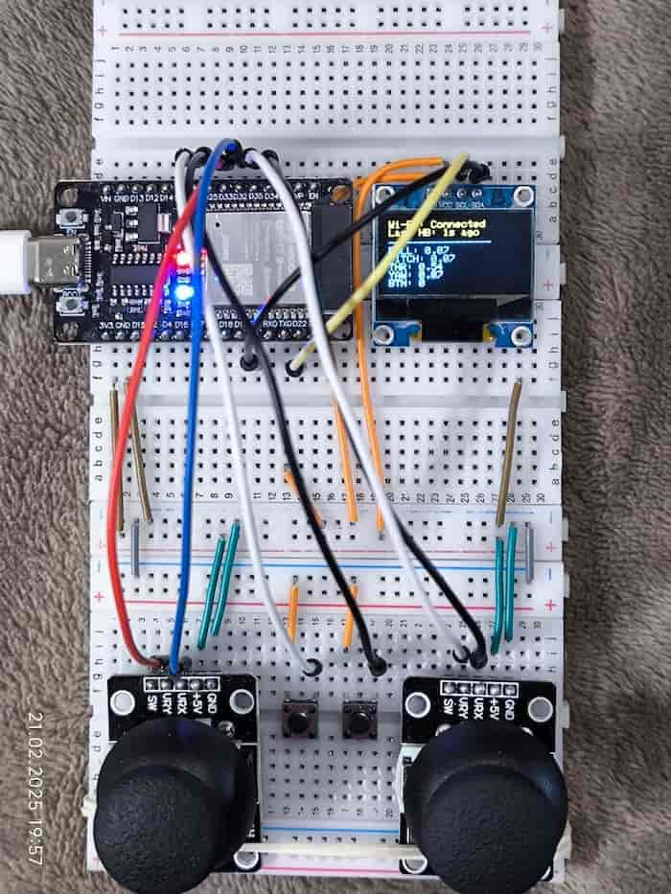
docs/img/user/p_kabakov/wifirc.jpg
