Tamim101/Sky_Watch/docs/img/user/peter_ukhov-2/video.jpg

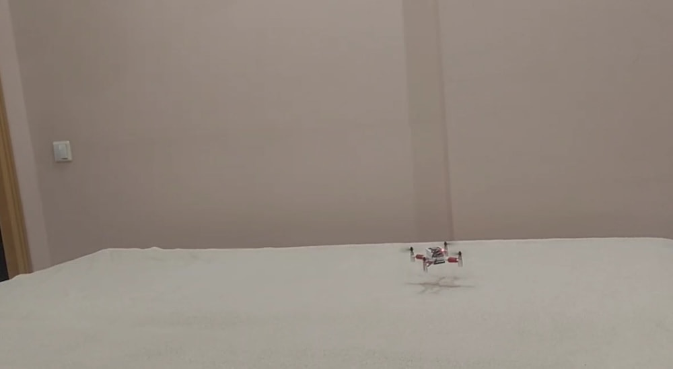
docs/img/user/peter_ukhov-2/video.jpg
