Tamim101/Sky_Watch/docs/img/user/peter_ukhov/1.jpg

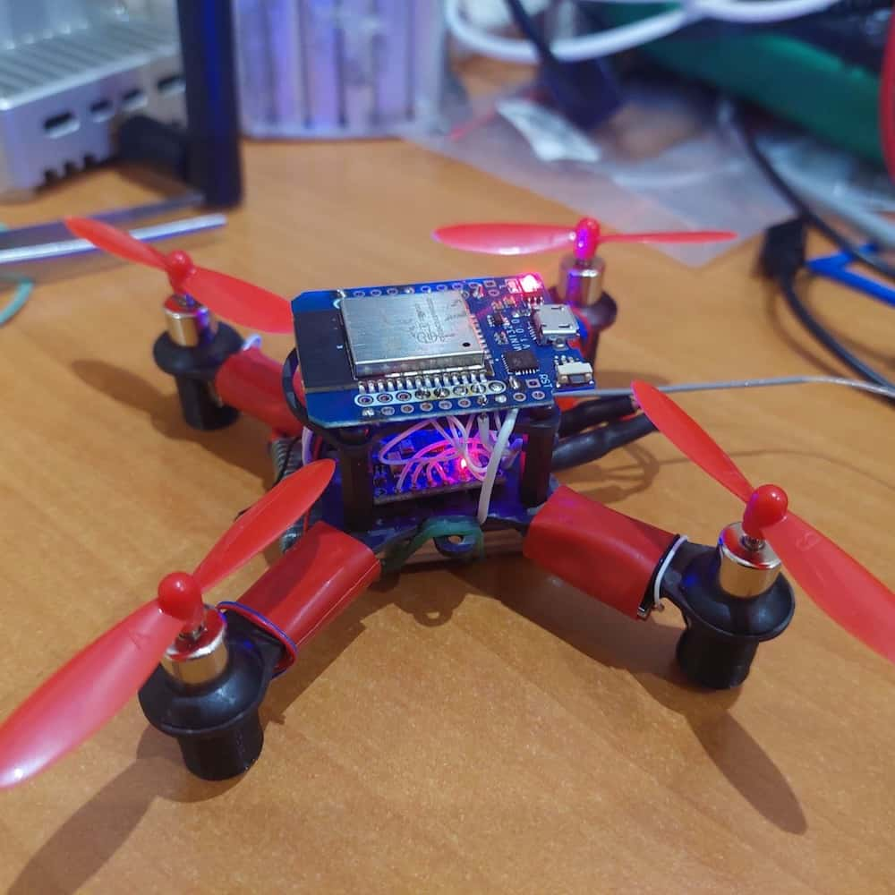
docs/img/user/peter_ukhov/1.jpg
