Tamim101/Sky_Watch/docs/img/user/peter_ukhov/2.jpg

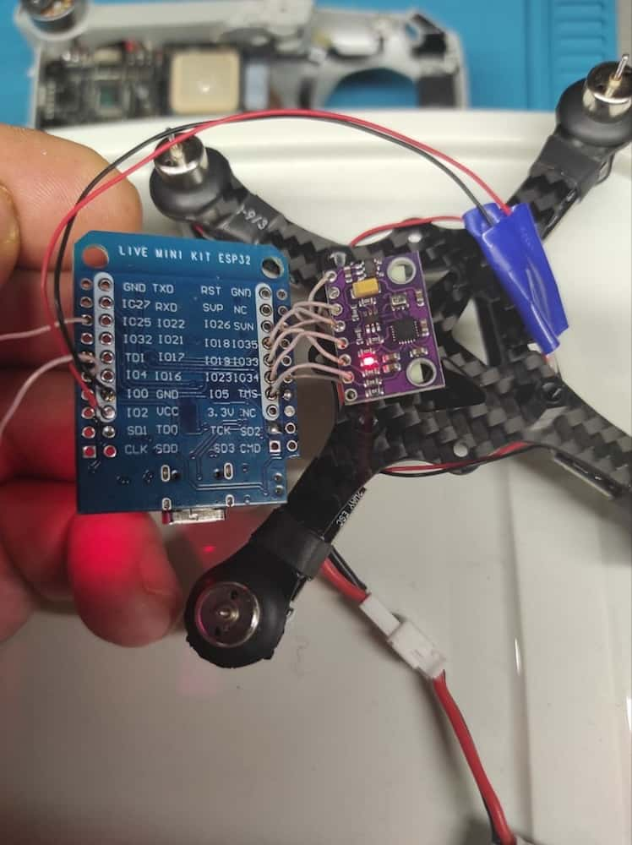
docs/img/user/peter_ukhov/2.jpg
