Tamim101/Sky_Watch/docs/img/user/peter_ukhov/3.jpg

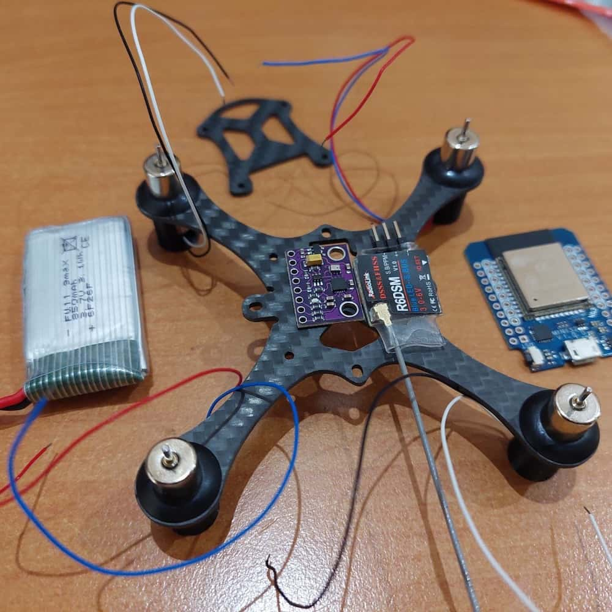
docs/img/user/peter_ukhov/3.jpg
