Tamim101/Sky_Watch/docs/img/user/peter_ukhov/video.jpg

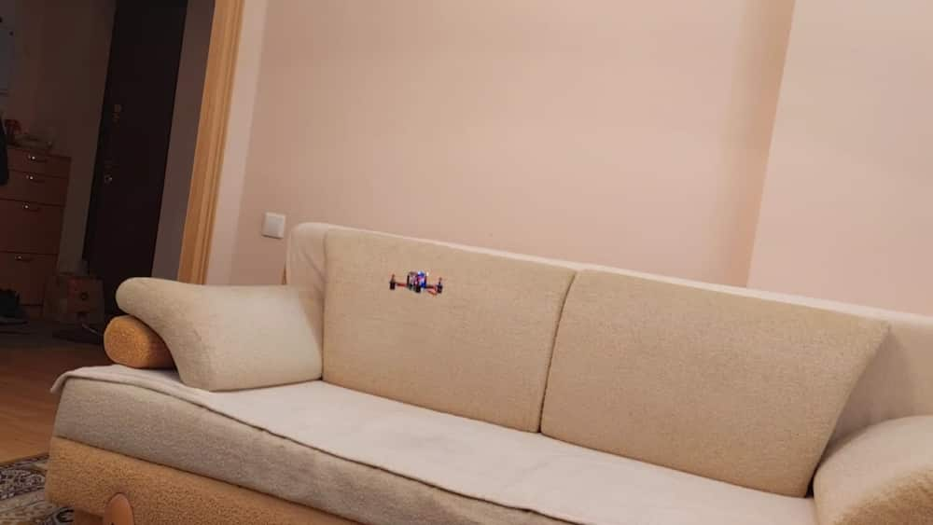
docs/img/user/peter_ukhov/video.jpg
