Tamim101/Sky_Watch/docs/img/user/robocamp/1.jpg

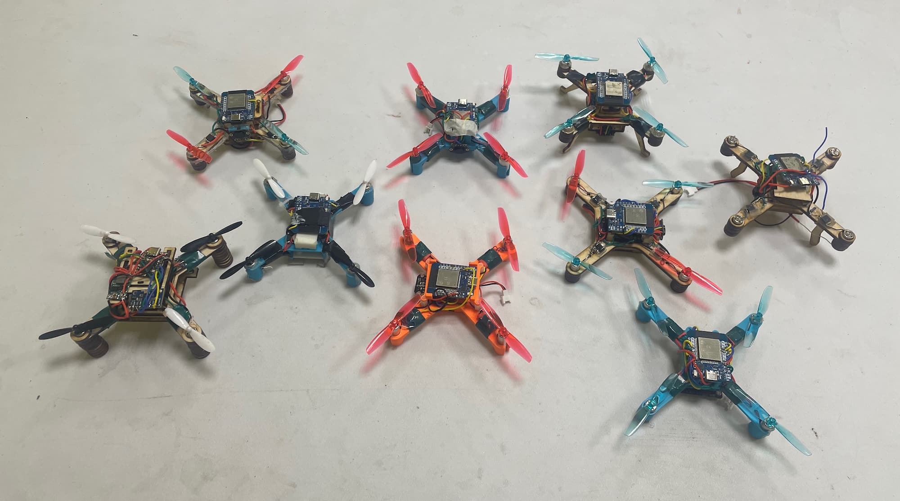
docs/img/user/robocamp/1.jpg
