Tamim101/Sky_Watch/docs/img/user/rudpa/1.jpg

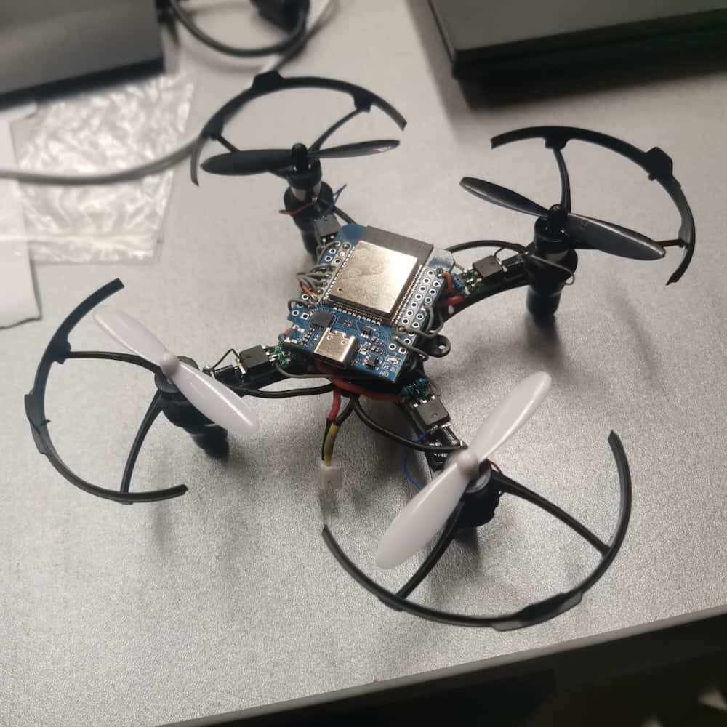
docs/img/user/rudpa/1.jpg
