Tamim101/Sky_Watch/docs/img/user/rudpa/2.jpg

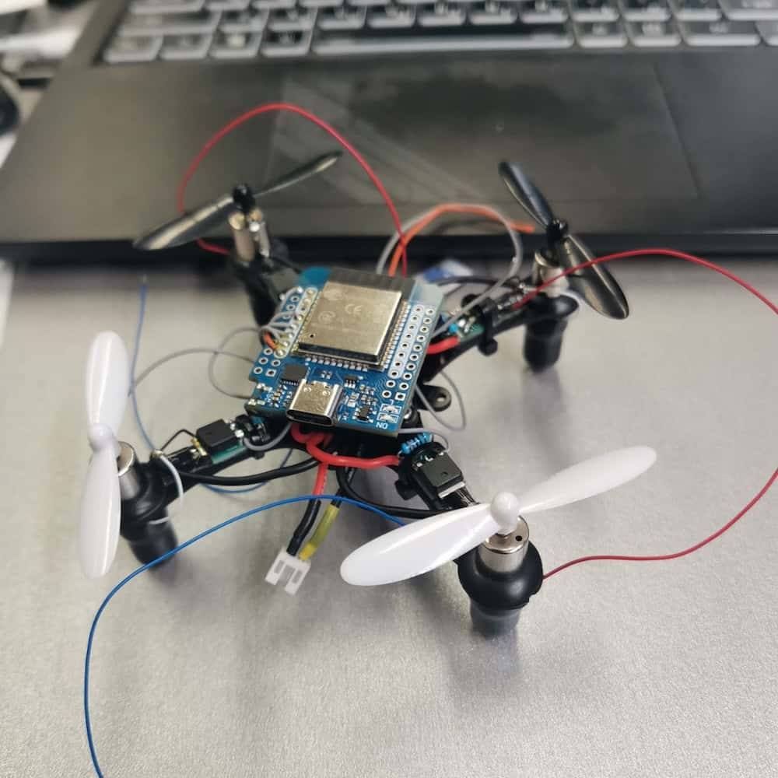
docs/img/user/rudpa/2.jpg
