Tamim101/Sky_Watch/docs/img/user/rudpa/3.jpg

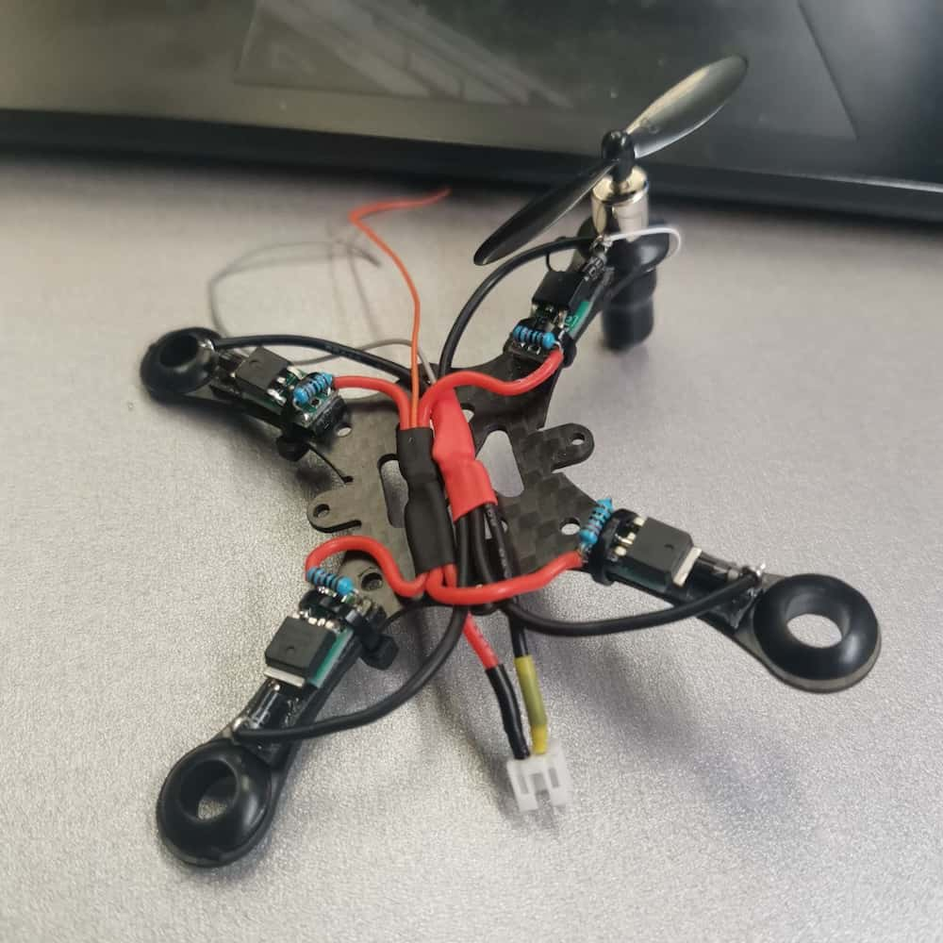
docs/img/user/rudpa/3.jpg
