Tamim101/Sky_Watch/docs/img/user/rudpa/video.jpg

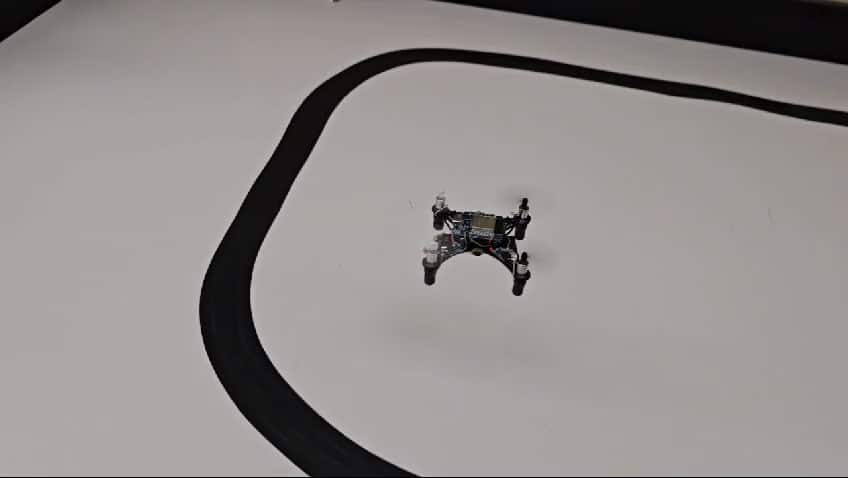
docs/img/user/rudpa/video.jpg
