Tamim101/Sky_Watch/docs/img/user/school548/1.jpg

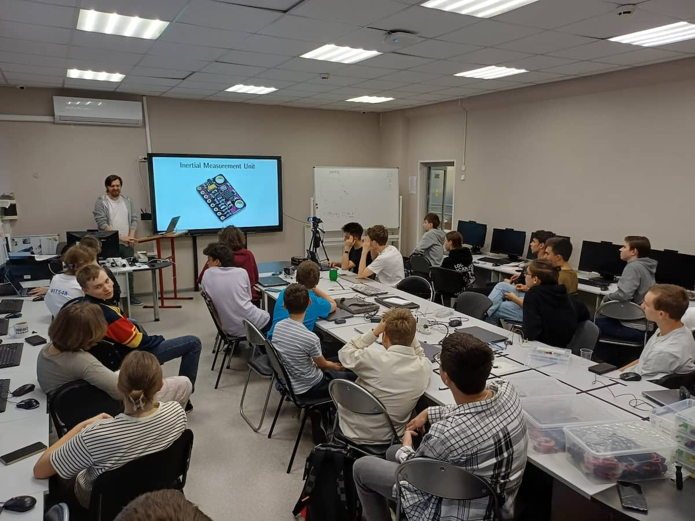
docs/img/user/school548/1.jpg
