Tamim101/Sky_Watch/docs/img/user/school548/3.jpg

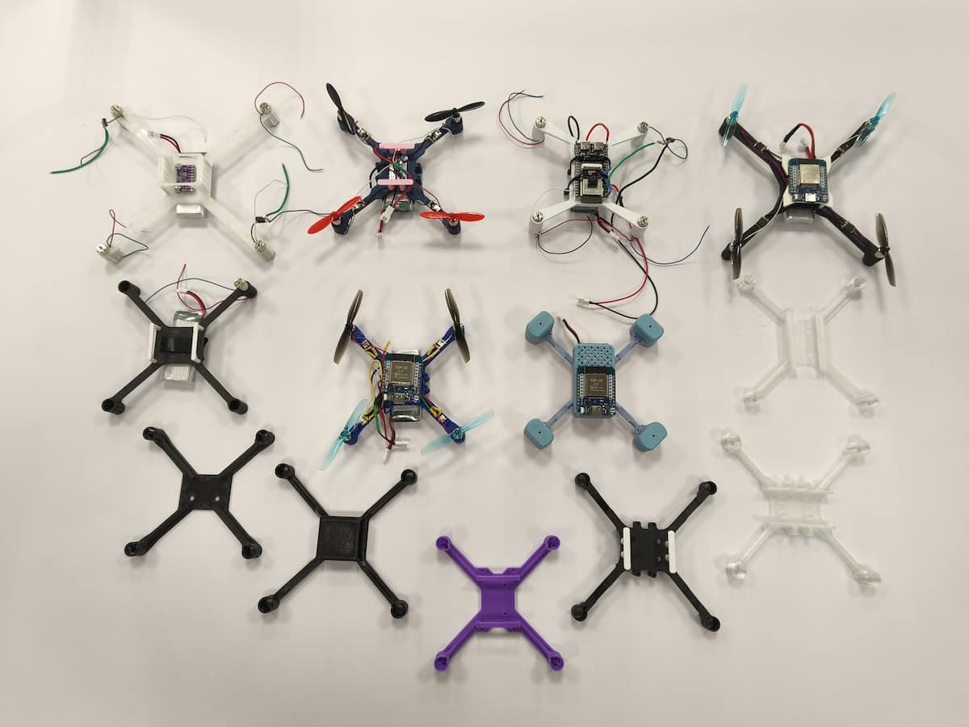
docs/img/user/school548/3.jpg
