Tamim101/Sky_Watch/docs/img/user/school548/kiraflux1.jpg

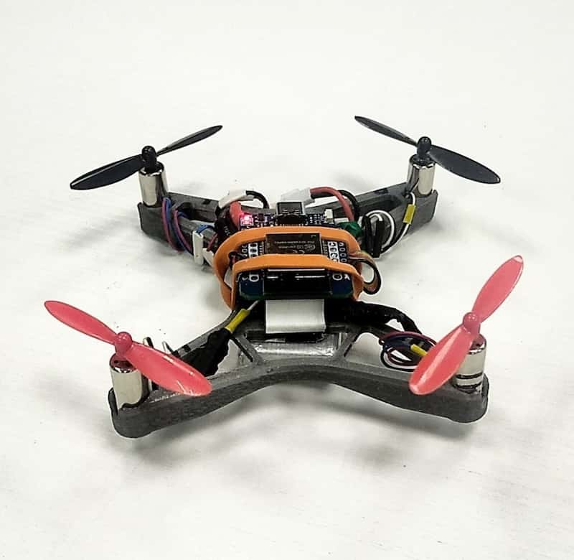
docs/img/user/school548/kiraflux1.jpg
