Tamim101/Sky_Watch/docs/img/user/school548/kiraflux2.jpg

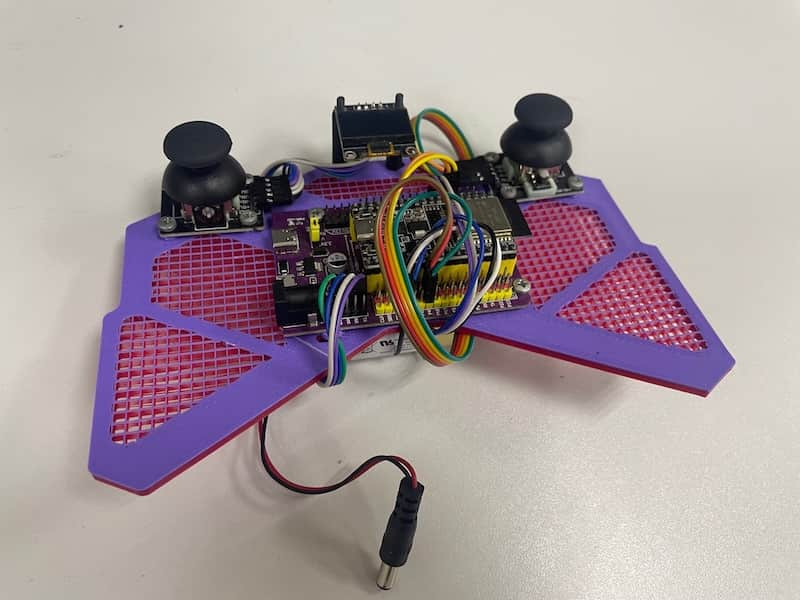
docs/img/user/school548/kiraflux2.jpg
