Tamim101/Sky_Watch/docs/img/user/school548/kiraflux-video.jpg

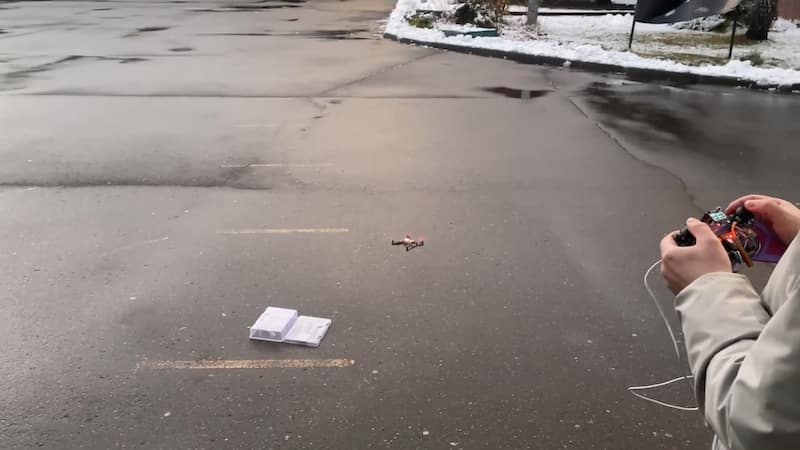
docs/img/user/school548/kiraflux-video.jpg
