Tamim101/Sky_Watch/docs/img/user/school548/tolyan4krut-video.jpg

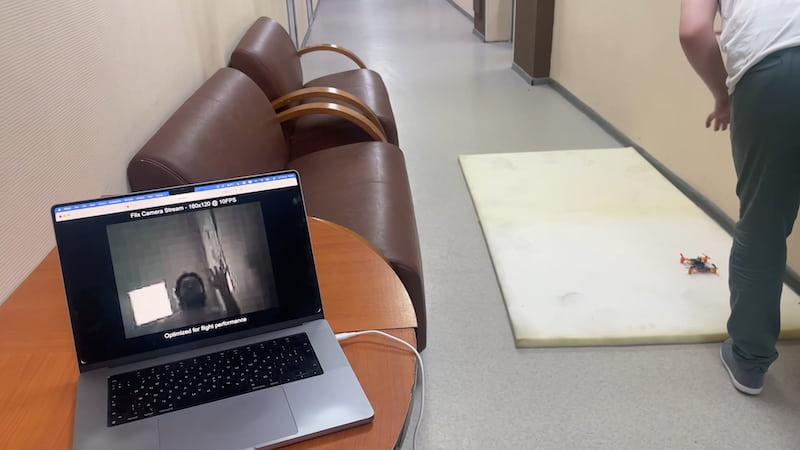
docs/img/user/school548/tolyan4krut-video.jpg
