Tamim101/Sky_Watch/docs/img/user/school548/vlad_tolshinov1.jpg

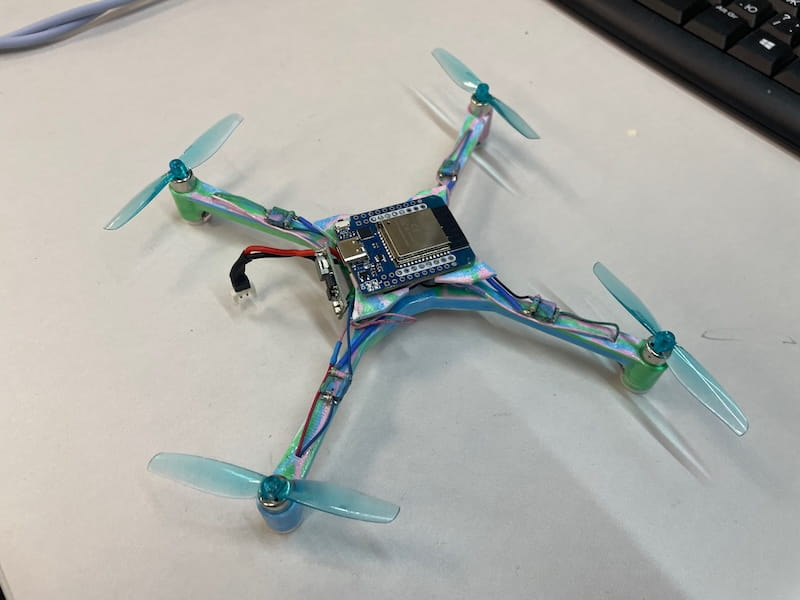
docs/img/user/school548/vlad_tolshinov1.jpg
