Tamim101/Sky_Watch/docs/img/user/school548/vlad_tolshinov2.jpg

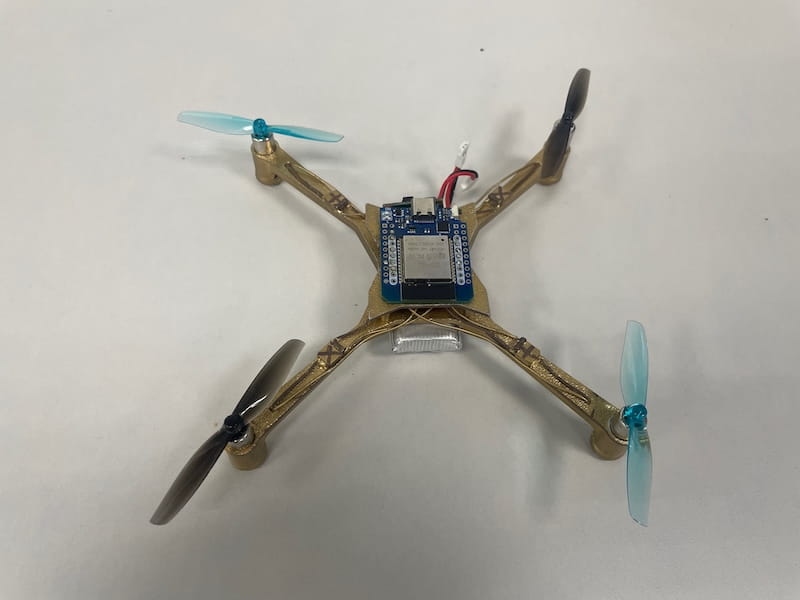
docs/img/user/school548/vlad_tolshinov2.jpg
