Tamim101/Sky_Watch/docs/img/user/school548/vlad_tolshinov-video.jpg

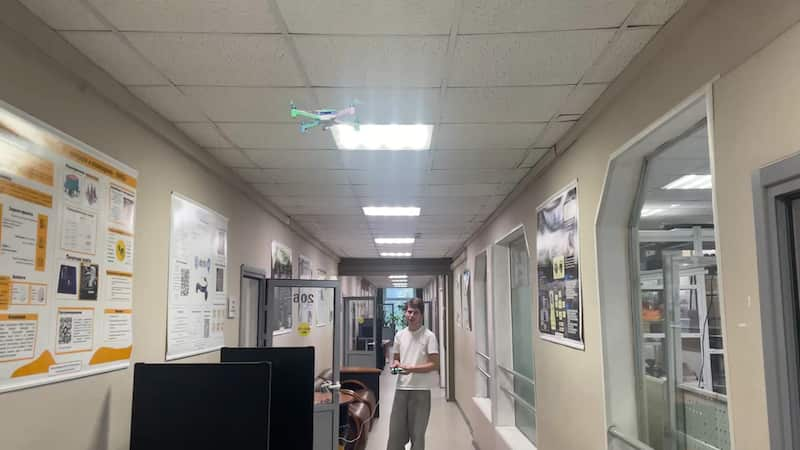
docs/img/user/school548/vlad_tolshinov-video.jpg
