Tamim101/Sky_Watch/docs/img/user/user.jpg

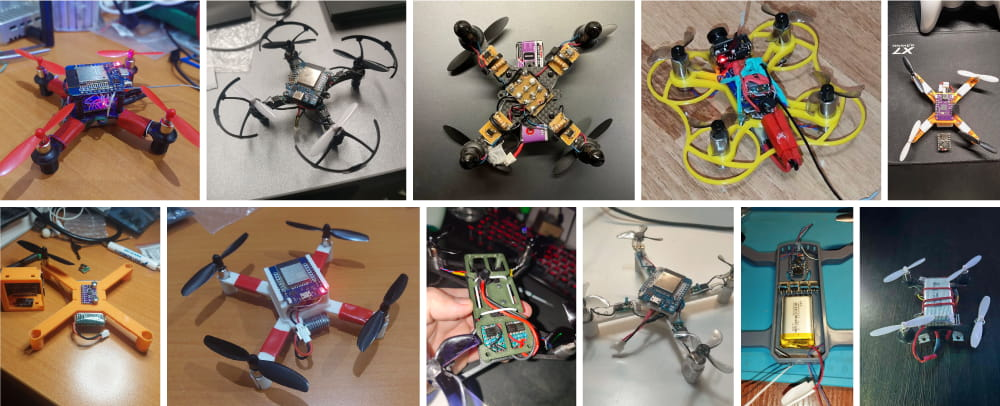
docs/img/user/user.jpg
