Tamim101/Sky_Watch/docs/img/user/yi_lun/1.jpg

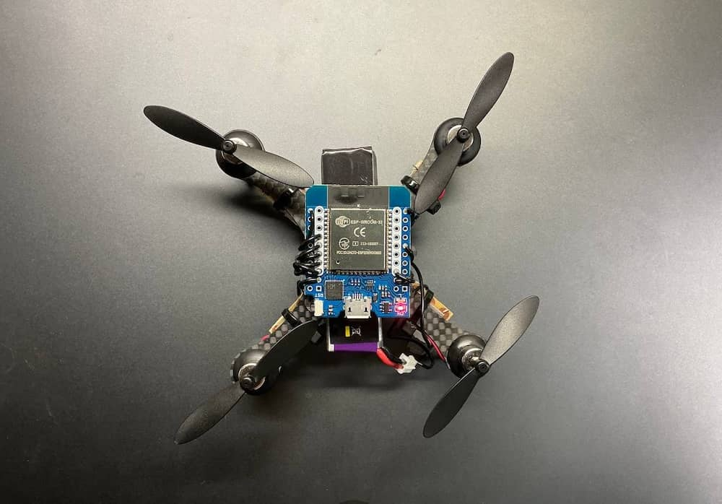
docs/img/user/yi_lun/1.jpg
