Tamim101/Sky_Watch/docs/img/user/yi_lun/2.jpg

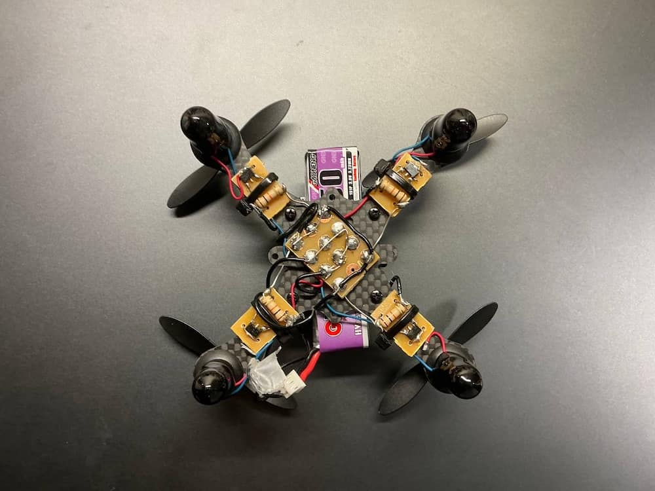
docs/img/user/yi_lun/2.jpg
