Tamim101/Sky_Watch/docs/img/washer-m3.jpg

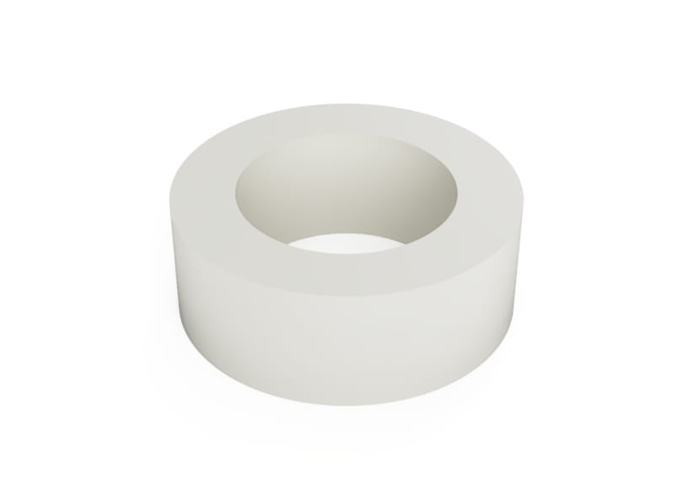
docs/img/washer-m3.jpg
