Tamim101/Sky_Watch/docs/img/wire-28awg.jpg

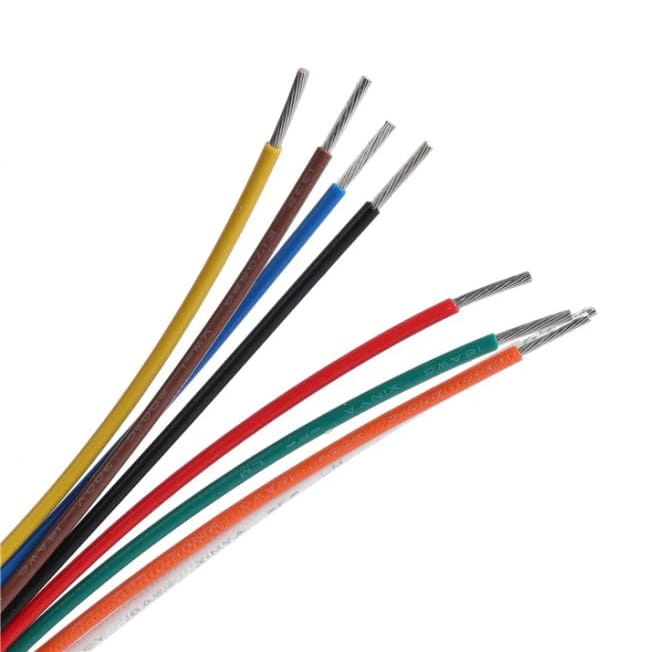
docs/img/wire-28awg.jpg
