Tamim101/Sky_Watch/user.image/WhatsApp Image 2026-03-02 at 8.53.20 PM.jpeg

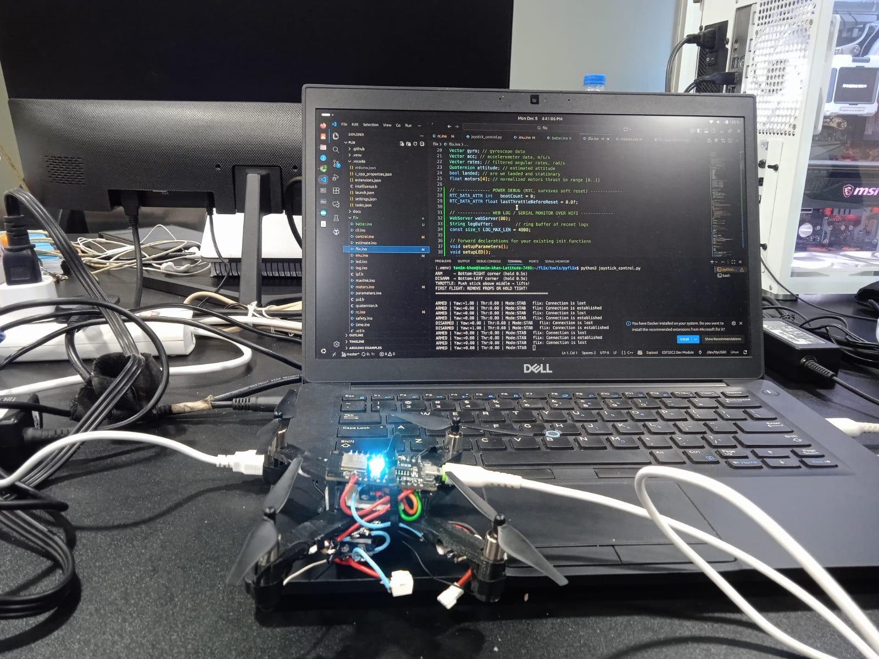
user.image/WhatsApp Image 2026-03-02 at 8.53.20 PM.jpeg
