Tamim101/Sky_Watch/gazebo/models/floor/materials/textures/floor.jpg

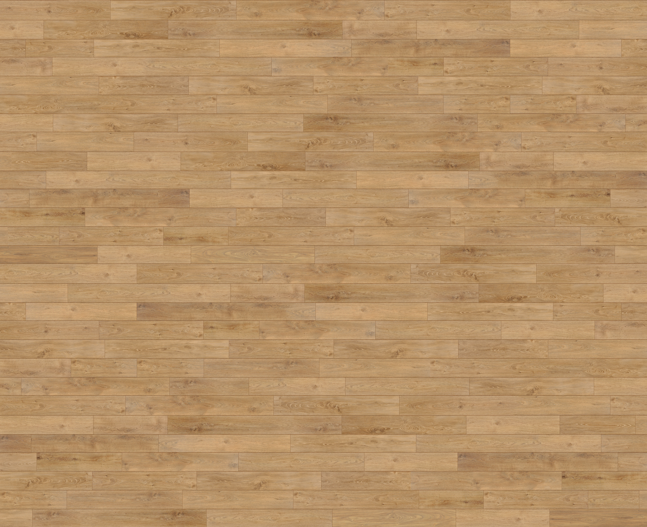
gazebo/models/floor/materials/textures/floor.jpg
