Tamim101/Sky_Watch/gazebo/models/flix/flix.stl

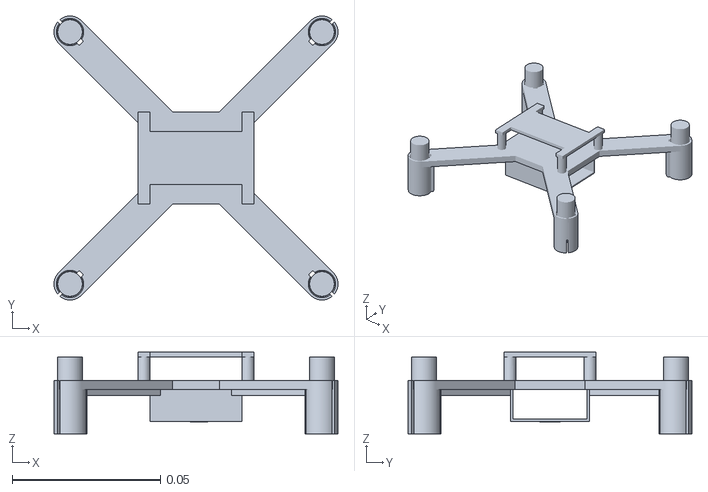
[picture p110: CAD file, 2026-03-13]
gazebo/models/flix/flix.stl
0.0957 x 0.0957 x 0.0276
