Tamim101/Sky_Watch/docs/assets/esp32-holder.step

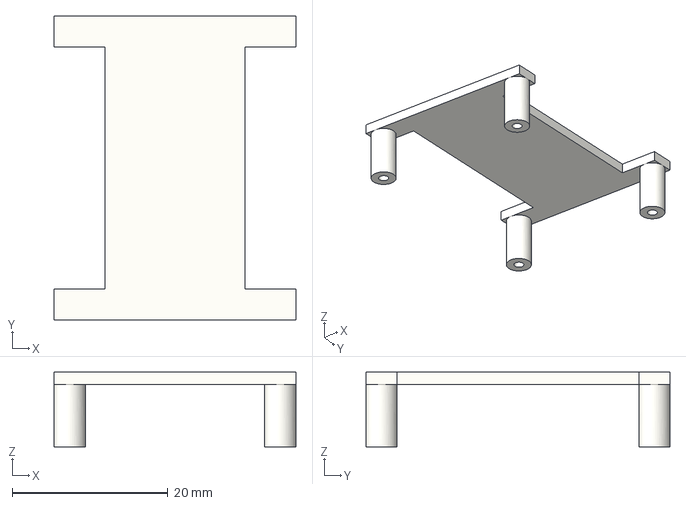
[picture p111: CAD file, 2026-03-13]
docs/assets/esp32-holder.step
31.0 x 39.0 x 9.60 mm
