Tamim101/Sky_Watch/docs/assets/flix-frame.step

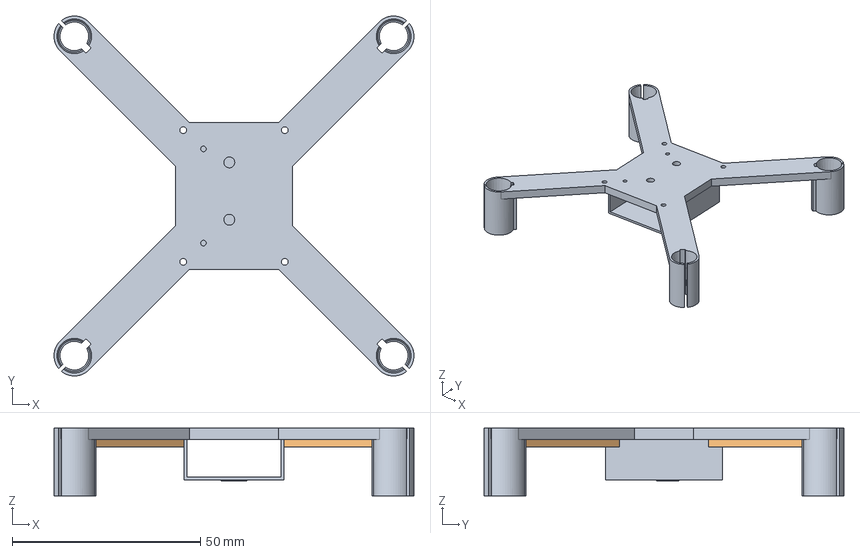
[picture p112: CAD file, 2026-03-13]
docs/assets/flix-frame.step
95.6 x 95.6 x 18.0 mm
