Tamim101/Sky_Watch/docs/assets/washer-m3.step

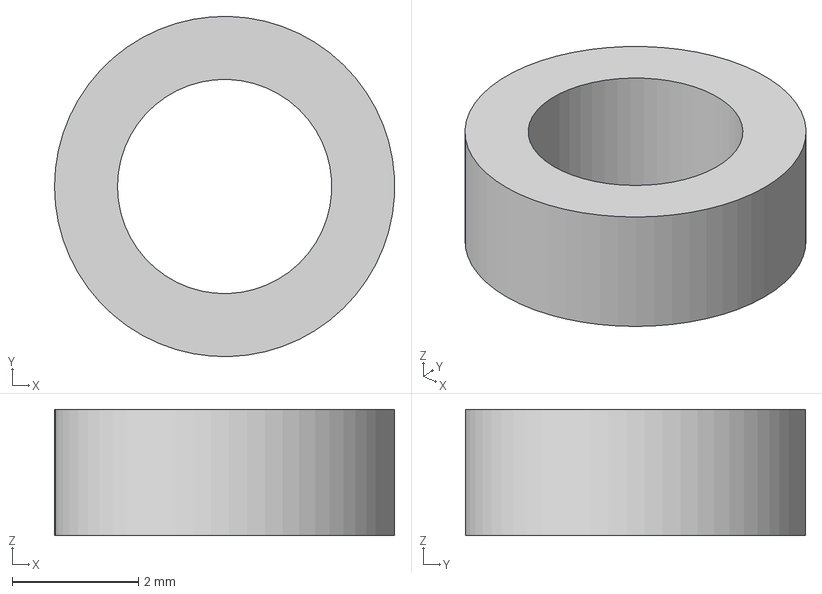
[picture p113: CAD file, 2026-03-13]
docs/assets/washer-m3.step
5.40 x 5.40 x 2.00 mm
