Tamim101/Sky_Watch/(list of files, cad)

Other CAD files:
docs/assets/flix-frame-1.1.step
docs/assets/esp32-holder.stl
docs/assets/flix-frame-1.1.stl
docs/assets/flix-frame.stl
docs/assets/washer-m3.stl
