Tamim101/Sky_Watch/docs/assembly.md

# Brief assembly guide

Soldered components ([schematics variant](https://miro.com/app/board/uXjVN-dTjoo=/?moveToWidget=3458764612338222067&cot=14)):

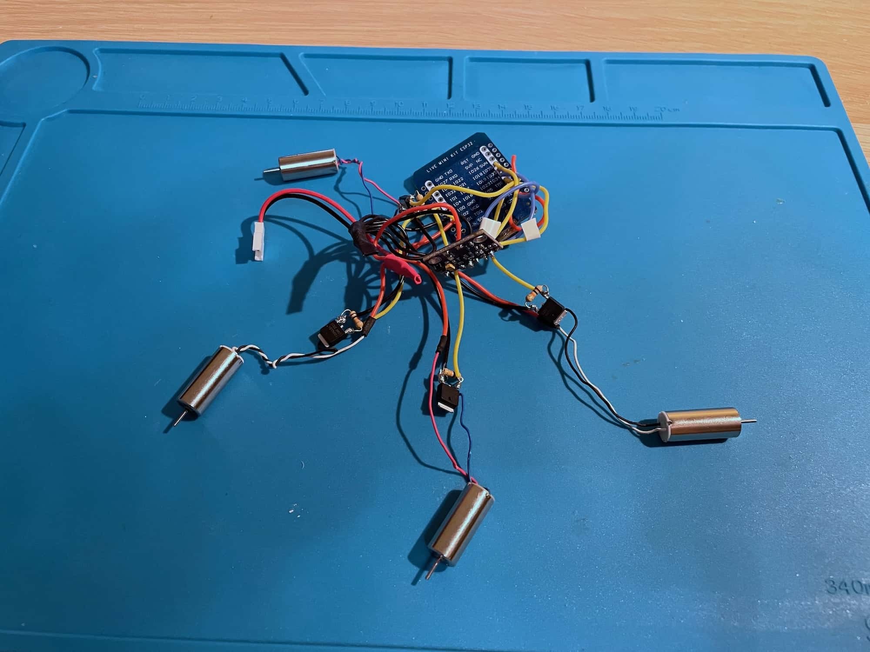
[picture p114: docs/img/assembly/1.jpg]


<br>Use double-sided tape to attach ESP32 to the top frame part (ESP32 holder):

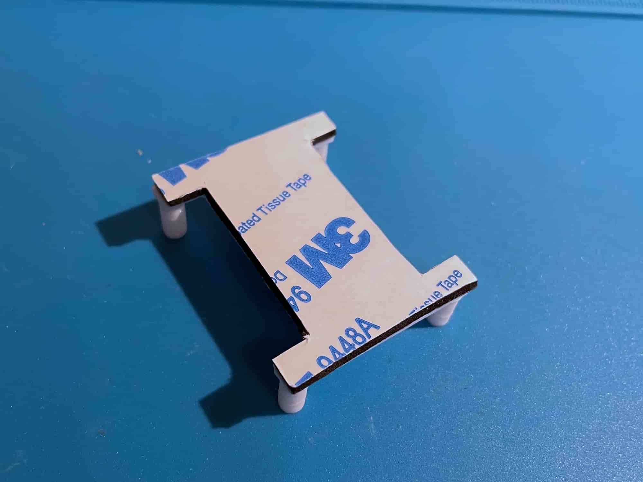
[picture p115: docs/img/assembly/2.jpg]


<br>Use two washers to screw the IMU board to the frame:

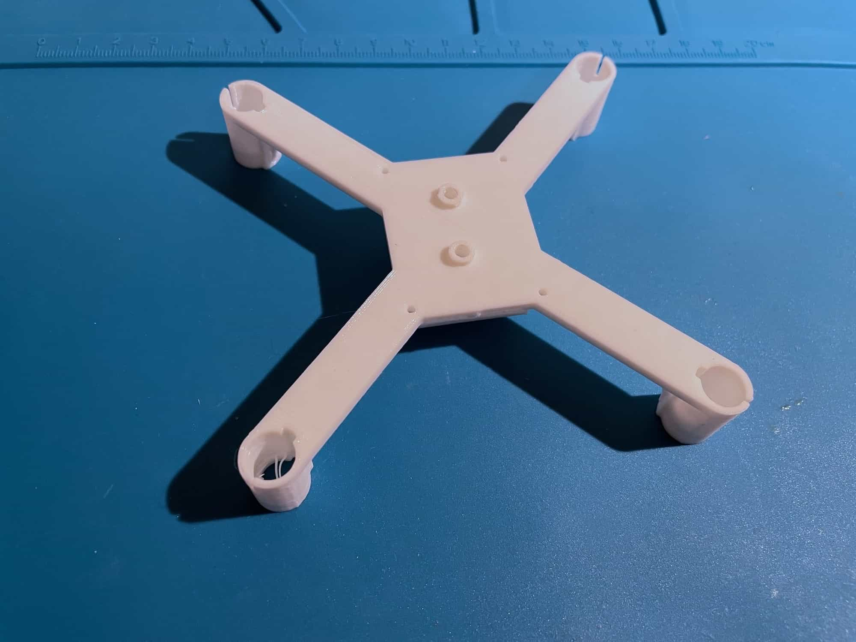
[picture p116: docs/img/assembly/3.jpg]


<br>Screw the IMU with M3x5 screws as shown:

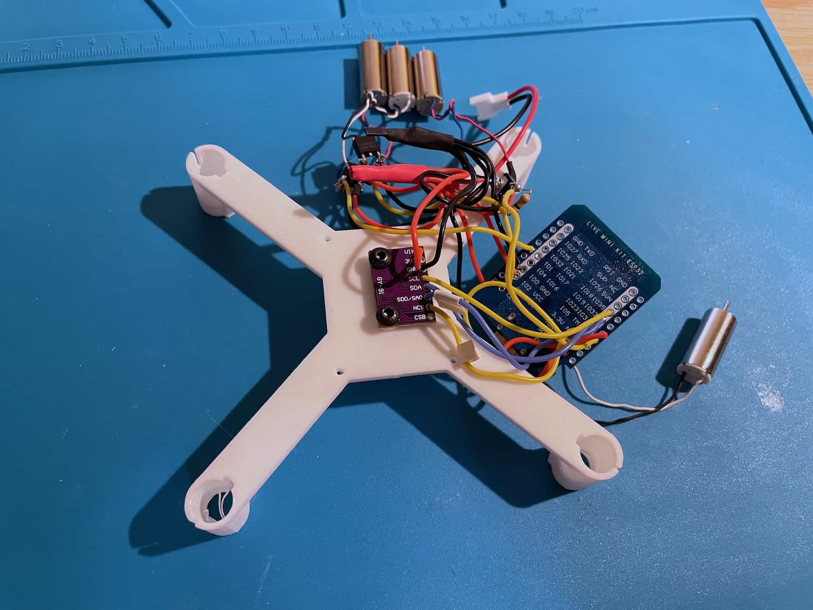
[picture p117: docs/img/assembly/4.jpg]


<br>Install the motors, attach MOSFETs to the frame using tape:

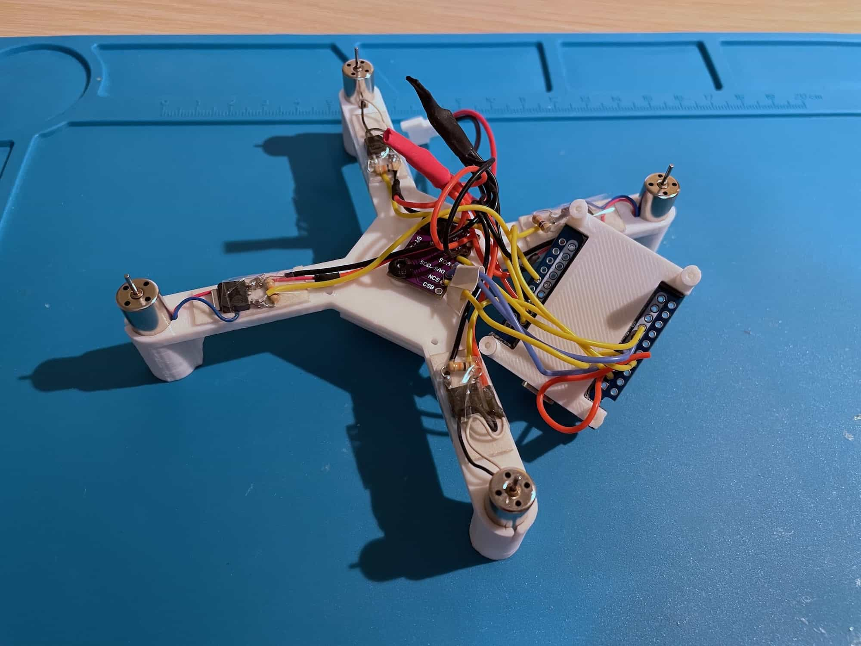
[picture p118: docs/img/assembly/5.jpg]


<br>Screw the ESP32 holder with M1.4x5 screws to the frame:

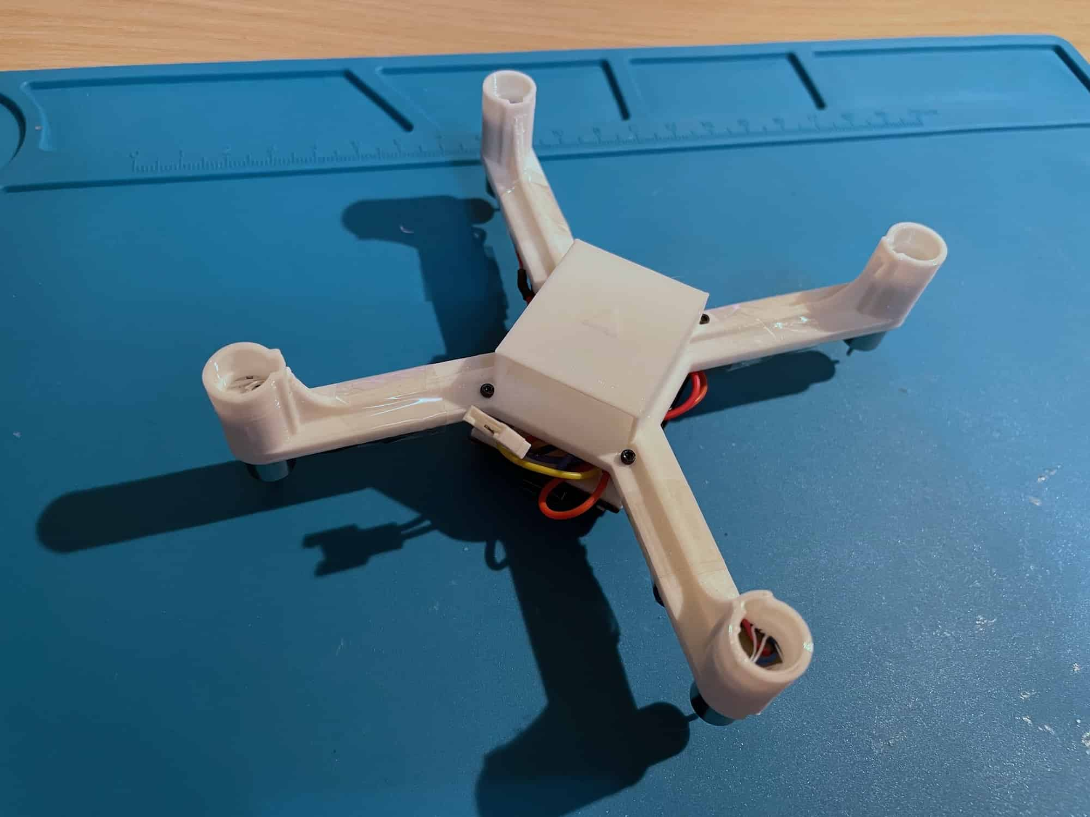
[picture p119: docs/img/assembly/6.jpg]


<br>Assembled drone:

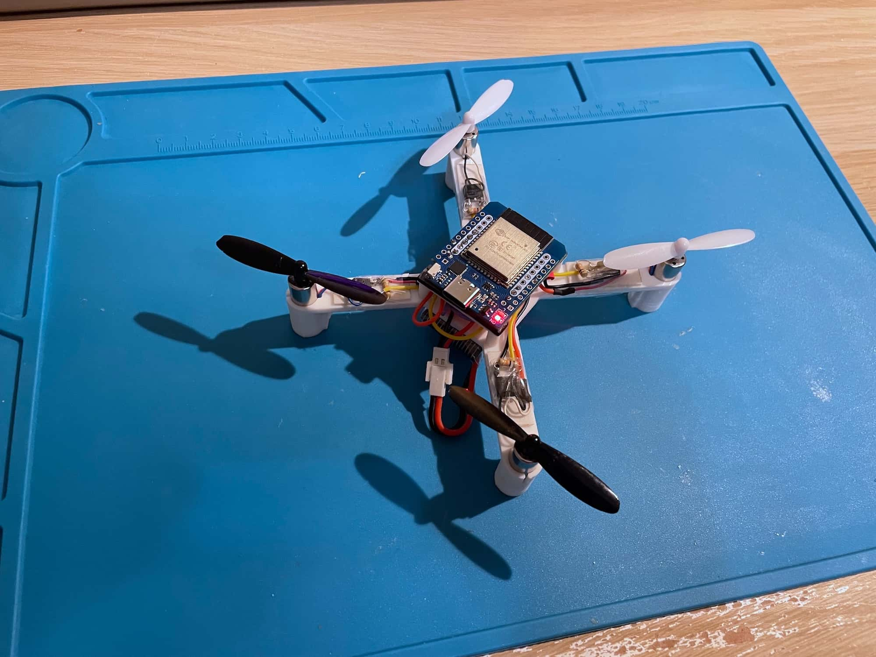
[picture p120: docs/img/assembly/7.jpg]


## Motor directions

> [!WARNING]
> The drone above is an early build, and it has **inversed** motor directions scheme. The photos only illustrate the assembly process in general.

Use standard motor directions scheme:



Motors connection table:

|Motor|Position|Direction|Prop type|Motor wires|GPIO|
|-|-|-|-|-|-|
|Motor 0|Rear left|Counter-clockwise|B|Black & White|GPIO12 *(TDI)*|
|Motor 1|Rear right|Clockwise|A|Blue & Red|GPIO13 *(TCK)*|
|Motor 2|Front right|Counter-clockwise|B|Black & White|GPIO14 *(TMS)*|
|Motor 3|Front left|Clockwise|A|Blue & Red|GPIO15 *(TD0)*|

## Motors tightening

Motors should be installed very tightly — any vibration may lead to bad attitude estimation and unstable flight. If motors are loose, use tiny tape pieces to fix them tightly as shown below:

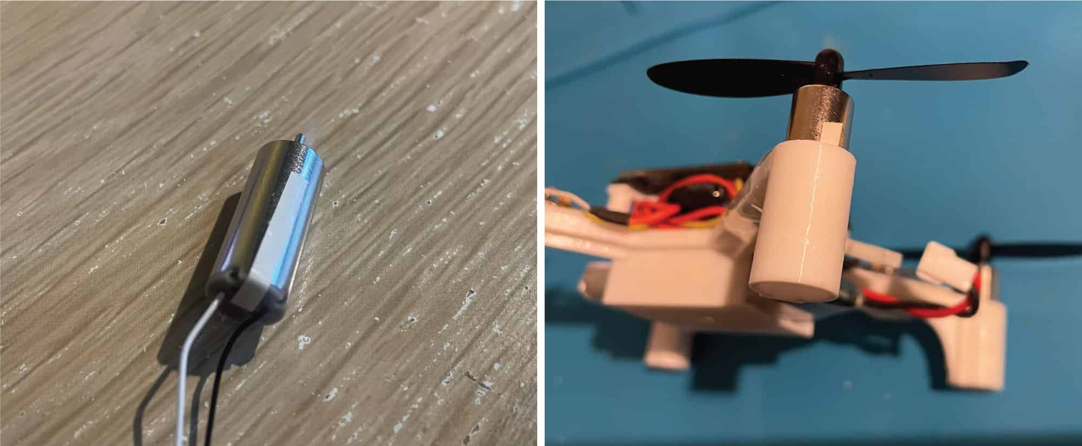
[picture p121: docs/img/motor-tape.jpg]
