Tamim101/Sky_Watch/docs/img/gyro-calibrated-plotter.png

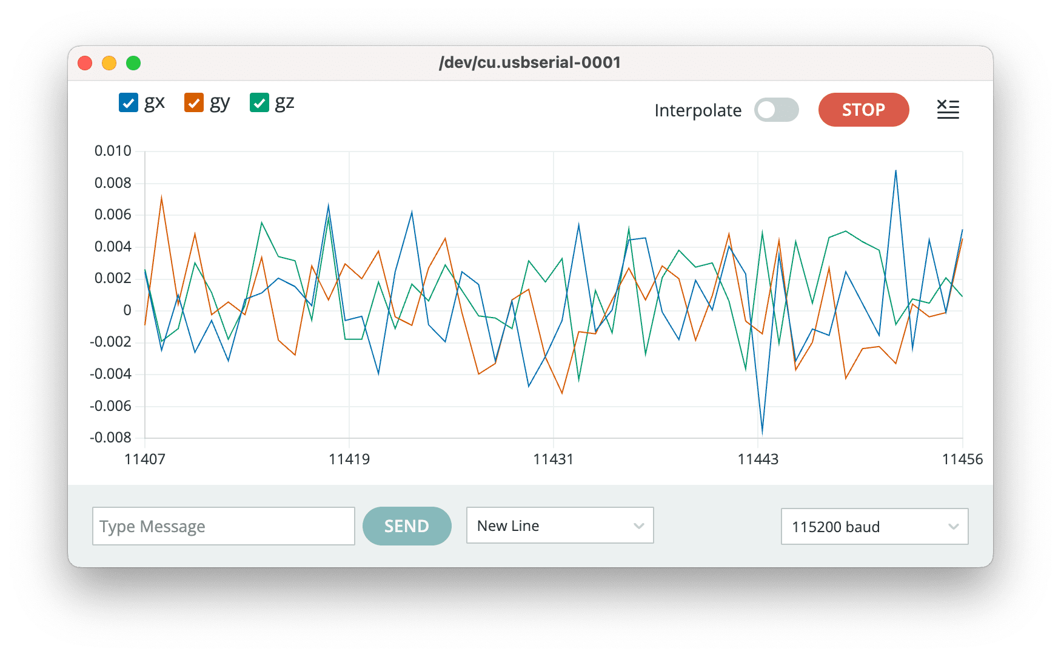
docs/img/gyro-calibrated-plotter.png
