Tamim101/Sky_Watch/docs/img/gyro-uncalibrated-plotter.png

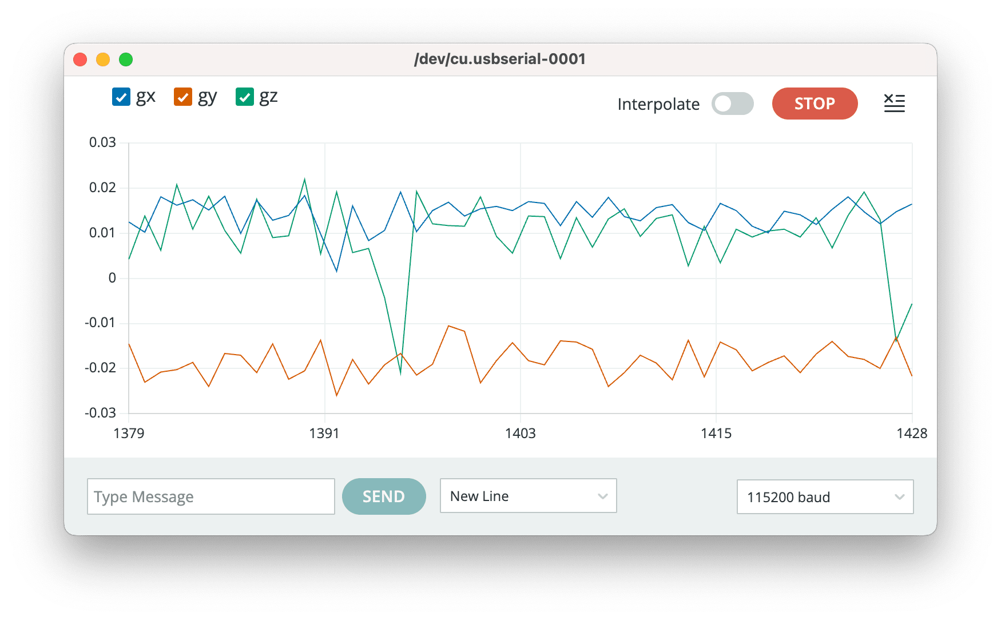
docs/img/gyro-uncalibrated-plotter.png
