Tamim101/Sky_Watch/flix/flix.ino

// Main firmware file

#include "vector.h"
#include "quaternion.h"
#include "util.h"

extern float t, dt;
extern float controlRoll, controlPitch, controlYaw, controlThrottle, controlMode;
extern Vector gyro, acc;
extern Vector rates;
extern Quaternion attitude;
extern bool landed;
extern float motors[4];

void setup() {
	Serial.begin(115200);
	print("Initializing flix\n");
	disableBrownOut();
	setupParameters();
	setupLED();
	setLED(true);
	setupMotors();
	setupWiFi();
	setupIMU();
	setupRC();
	setLED(false);
	print("Initializing complete\n");
}

void loop() {
	readIMU();
	step();
	readRC();
	estimate();
	control();
	sendMotors();
	handleInput();
	processMavlink();
	logData();
	syncParameters();
}
