Tamim101/Sky_Watch/(commit log)

2025-11-11 add motor
2025-11-12 add motor update
2025-11-12 add cli to connect pid control
2025-11-13 add imu
2025-11-16 code add led app
2025-11-17 add vector pic roll and yaw collect data
2025-11-19 framere were setup
2025-11-21 change imu code
2025-11-24 imu done
2025-12-01 update motor
2025-12-11 add alll .h file in flipe code
    [pid.h]
2025-12-11 add pid cpp file in flipe code
2025-12-14 add motor gpioa pin change
2025-12-15 fix imu and arm true every place
2025-12-17 add and fix imu code change the real value
2026-01-01 remove motor
2026-01-07 imu add
2026-01-09 implement them motor add
2026-01-10 change motor
2026-01-13 new imu
2026-03-13 fix the all file
    [esp32-holder.step, esp32-holder.stl, flix-frame-1.1.step, flix-frame-1.1.stl, flix-frame.step, flix-frame.stl, flix.sdf, flix.stl]
